harisama1/health-watch/docs/datasheets/README.md

# Datasheet (không kèm file PDF)

Datasheet thuộc bản quyền của các hãng nên repo public chỉ ghi link tải. Tải về đặt đúng tên file bên dưới vào thư mục này thì các script (`tools/facts.py`, `tools/gen_report.py`) và số trang trích dẫn trong báo cáo dùng được ngay.

| Khóa | Tên file | Link tải |
|---|---|---|
| DS | `ESP32-S3_Datasheet.pdf` | https://www.espressif.com/sites/default/files/documentation/esp32-s3_datasheet_en.pdf |
| HDG | `ESP32-S3_Hardware_Design_Guidelines.pdf` | https://docs.espressif.com/projects/esp-hardware-design-guidelines/en/latest/esp32s3/ |
| AXP | `LCSC_C3036461_AXP2101.pdf` | https://datasheet.lcsc.com/datasheet/pdf/4f32bb3c83a61e426b4e09c536b24324.pdf |
| MAX | `LCSC_C5328762_MAX86141.pdf` | https://datasheet.lcsc.com/datasheet/pdf/1b56645c68829ff2d7fd003b7bd91a43.pdf |
| M30 | `LCSC_C2874216_MAX30208.pdf` | https://datasheet.lcsc.com/datasheet/pdf/563d638fdd3523dd5760ec7178c4a6f5.pdf |
| RTC | `PCF85063A.pdf` | https://www.nxp.com/docs/en/data-sheet/PCF85063A.pdf |
| ANT | `Johanson_2450AT18D0100.pdf` | https://datasheet.lcsc.com/datasheet/pdf/43cf7506e0cad9725529346917105458.pdf |
| FPC | `HDGC_0.3K-HX-nPWB.pdf` | https://datasheet.lcsc.com/datasheet/pdf/a443f3b35bf2c7fb425b32754489b934.pdf |
| BMI | `Bosch_BMI270_datasheet.pdf` | https://www.bosch-sensortec.com/media/boschsensortec/downloads/datasheets/bst-bmi270-ds000.pdf |
| TPS | `LCSC_C133991_TPS61240.pdf` | https://datasheet.lcsc.com/datasheet/pdf/91a1f9e8f79a4c3caf35dfe137175767.pdf |
| TXS | `LCSC_C17206_TXS0108E.pdf` | https://datasheet.lcsc.com/datasheet/pdf/3d1219eaadc44a01a8b9ea151a0ff2ba.pdf |
| LP | `LCSC_C92498_LP5907-1.8.pdf` | https://datasheet.lcsc.com/datasheet/pdf/bce283a90e88d150b0b3cedeeb5142ca.pdf |
| W25 | `LCSC_C97521_W25Q128JVSIQ.pdf` | https://datasheet.lcsc.com/datasheet/pdf/d009d960f1daec6149edaa35b7dae856.pdf |
| SFH | `OSRAM_SFH7016.pdf` | https://look.ams-osram.com/m/1a73f8d425cfcc40/original/SFH-7016.pdf |
| VEMD | `LCSC_C511402_VEMD8080.pdf` | https://datasheet.lcsc.com/datasheet/pdf/a9a8ceb088c6fc1e24875b4d80ce77a2.pdf |
| LC6 | `LCSC_C7519_USBLC6-2SC6.pdf` | https://datasheet.lcsc.com/datasheet/pdf/0d3a2ab954b34651a0695e7ccf534db0.pdf |
| TYC | `LCSC_C165948_TYPE-C-31-M-12.pdf` | https://datasheet.lcsc.com/datasheet/pdf/9e56b777c022540fcce7c7f67825f55e.pdf |
| XT | `LCSC_C9010_X322540MPB4SI_40MHz.pdf` | https://datasheet.lcsc.com/datasheet/pdf/a84bd8d530dd46e4b0f6d0ee59d8a89c.pdf |
| TS | `LCSC_C720477_TS-1088_tact_switch.pdf` | https://datasheet.lcsc.com/datasheet/pdf/0475ac02febf455ca9ddcfb380b0df0d.pdf |
| AO | `LCSC_C15127_AO3401A.pdf` | https://datasheet.lcsc.com/datasheet/pdf/fee353dd1e9e0bc90b295f14f381aa4c.pdf |
| WS | `Waveshare_ESP32-S3-Touch-AMOLED-1.75C_schematic.pdf` | https://www.waveshare.com/wiki/ESP32-S3-Touch-AMOLED-1.75C (mục Resources → Schematic) |

Chưa có: NXP PCF85063A (https://www.nxp.com/docs/en/data-sheet/PCF85063A.pdf), Johanson 2450AT18A100, CUI CMT-8504 - xem mục rủi ro trong báo cáo.
