harisama1/health-watch/outputs/bom/health_watch_bom.xlsx

Sheet: Chi phí
Dự toán PCBA JLCPCB (Standard, 2 mặt, mỗi bo một đơn)
Giá đọc ngày 05/11/2026; đổi theo thời điểm
Số bộ (nhập tại đây) | 2
Setup 2 mặt | 51.12
Stencil 2 mặt | 16.42
Nạp feeder mỗi mã | 1.53
Mỗi mối hàn (0,016 + 0,0016) | 0.0176
Đóng gói + xác nhận vị trí | 0.95
Nguồn phí: jlcpcb.com/help/article/pcb-assembly-price
Hạng mục ($) | Bo chính | Bo cảm biến | Tổng
Linh kiện
Setup + stencil
Nạp feeder
Mối hàn
X-ray
Đóng gói + xác nhận vị trí
Tổng PCBA
Mua rời, chưa gồm màn hình
Tổng đã có giá
Chưa gồm: SFH 7016 và màn hình (chưa có giá), MAX86141 tính theo giá niêm yết khi hết hàng, PCB, vận chuyển, thuế, vỏ, phí fixture và handling nếu phát sinh.
Đơn giá dùng bậc 1 nên có thể cao hơn báo giá thật. Bo chưa có layout, nên số mối hàn lấy từ số chân trong design.py.

Sheet: Bo chính
Tham chiếu | SL/bộ | Giá trị | Footprint | Mã LCSC | Thư viện JLC | Tồn JLCPCB | Tồn LCSC | Mua tối thiểu | Hao hụt | Đơn giá bậc 1 ($) | SL mua | Thành tiền ($) | Chân/linh kiện | Mối hàn/bộ | Tính X-ray | Trạng thái
J101 | 1 | TYPE-C-31-M-12 | HW_IC:USB_C_Receptacle_16P_MidMount_TYPE-C-31-M-12 | C165948 | expand | 150499 | 140195 | 2 | 0 | 0.1868 |  |  | 17 |  | 0 | Đặt PCBA được
R101,R102 | 2 | 5.1k | Resistor_SMD:R_0402_1005Metric | C25905 | base | 4703687 | 1764200 | 20 | 15 | 0.0023 |  |  | 2 |  | 0 | Đặt PCBA được
U101 | 1 | USBLC6-2SC6 | Package_TO_SOT_SMD:SOT-23-6 | C7519 | expand | 45596 | 44985 | 5 | 2 | 0.1623 |  |  | 6 |  | 0 | Đặt PCBA được
R103,R104 | 2 | 22 | Resistor_SMD:R_0402_1005Metric | C25092 | base | 3679105 | 0 | 20 | 15 | 0.0019 |  |  | 2 |  | 0 | Đặt PCBA được
U102 | 1 | AXP2101 | Package_DFN_QFN:QFN-40-1EP_5x5mm_P0.4mm_EP3.6x3.6mm_ThermalVias | C3036461 | expand | 3195 | 3195 | 0 | 0 | 1.5618 |  |  | 41 |  | 1 | Đặt PCBA được
C101,C102,C115,C132 | 4 | 10uF 10V | Capacitor_SMD:C_0603_1608Metric | C19702 | base | 10688573 | 1579380 | 20 | 10 | 0.0203 |  |  | 2 |  | 0 | Đặt PCBA được
C103,C104,C111 | 3 | 22uF 6.3V | Capacitor_SMD:C_0603_1608Metric | C59461 | base | 4257105 | 1105580 | 20 | 10 | 0.0171 |  |  | 2 |  | 0 | Đặt PCBA được
C105,C106,C107,C109,C110,C116,C118,C123,C124 | 9 | 1uF | Capacitor_SMD:C_0402_1005Metric | C52923 | base | 9953631 | 1534400 | 20 | 12 | 0.0063 |  |  | 2 |  | 0 | Đặt PCBA được
C108,C113 | 2 | 2.2uF | Capacitor_SMD:C_0402_1005Metric | C12530 | base | 3721393 | 2009500 | 20 | 14 | 0.0054 |  |  | 2 |  | 0 | Đặt PCBA được
L101,L102 | 2 | 1uH 2.5A | Inductor_SMD:L_1008_2520Metric | C97029 | expand | 2402 |  | 5 | 4 | 0.0404 |  |  | 2 |  | 0 | Đặt PCBA được
R105 | 1 | 0R 0805 | Resistor_SMD:R_0805_2012Metric | C17477 | base | 4467978 | 2005100 | 20 | 10 | 0.0044 |  |  | 2 |  | 0 | Đặt PCBA được
RT101 | 1 | NTC 10k B3950 | Resistor_SMD:R_0402_1005Metric | C41366926 | expand | 11106 | 10800 | 20 | 8 | 0.018 |  |  | 2 |  | 0 | Đặt PCBA được
R106 | 1 | 4.7k | Resistor_SMD:R_0402_1005Metric | C25900 | base | 15980267 | 8774700 | 20 | 10 | 0.0017 |  |  | 2 |  | 0 | Đặt PCBA được
R107,R108 | 2 | 2.2k | Resistor_SMD:R_0402_1005Metric | C25879 | base | 3440881 | 1720400 | 20 | 10 | 0.0011 |  |  | 2 |  | 0 | Đặt PCBA được
R109 | 1 | 510 | Resistor_SMD:R_0402_1005Metric | C25123 | base | 2793746 | 1373100 | 20 | 12 | 0.0011 |  |  | 2 |  | 0 | Đặt PCBA được
C112 | 1 | 1nF | Capacitor_SMD:C_0402_1005Metric | C1523 | base | 2225028 | 0 | 20 | 15 | 0.0019 |  |  | 2 |  | 0 | Đặt PCBA được
SW101,SW102,SW103,SW104 | 4 | TS-1088 4x3mm | HW_IC:SW_SPST_TS-1088-xR020 | C720477 | base | 795887 | 576930 | 5 | 4 | 0.0527 |  |  | 2 |  | 0 | Đặt PCBA được
R110,R125 | 2 | 1k | Resistor_SMD:R_0402_1005Metric | C11702 | base | 34052494 | 22437900 | 20 | 10 | 0.0013 |  |  | 2 |  | 0 | Đặt PCBA được
D101 | 1 | Red 0603 | LED_SMD:LED_0603_1608Metric | C2286 | base | 6672378 | 4208500 | 20 | 10 | 0.0077 |  |  | 2 |  | 0 | Đặt PCBA được
J102 | 1 | LiPo 1S ~400mAh | Connector_Molex:Molex_PicoBlade_53261-0271_1x02-1MP_P1.25mm_Horizontal | C177225 | expand | 27625 | 27625 | 2 | 4 | 0.1417 |  |  | 3 |  | 0 | Đặt PCBA được
R111 | 1 | 0.05R 1% 0805 | Resistor_SMD:R_0805_2012Metric | C247602 | expand | 283713 | 283700 | 20 | 10 | 0.0097 |  |  | 2 |  | 0 | Đặt PCBA được
R112,R114 | 2 | 0.1R 1% 0603 | Resistor_SMD:R_0603_1608Metric | C111027 | expand | 73336 | 53400 | 20 | 10 | 0.007 |  |  | 2 |  | 0 | Đặt PCBA được
U103 | 1 | TPS61240DRVT | Package_SON:WSON-6-1EP_2x2mm_P0.65mm_EP1x1.6mm | C133991 | expand | 50 | 50 | 0 | 0 | 1.5389 |  |  | 7 |  | 1 | Đặt PCBA được
L103 | 1 | 1uH 1A | Inductor_SMD:L_0805_2012Metric | C98332 | expand | 42789 |  | 5 | 4 | 0.0591 |  |  | 2 |  | 0 | Đặt PCBA được
C114 | 1 | 4.7uF | Capacitor_SMD:C_0603_1608Metric | C19666 | base | 4144040 | 1307670 | 20 | 10 | 0.015 |  |  | 2 |  | 0 | Đặt PCBA được
R113 | 1 | 1M | Resistor_SMD:R_0402_1005Metric | C26083 | base | 2814158 | 1121900 | 20 | 15 | 0.0015 |  |  | 2 |  | 0 | Đặt PCBA được
U104 | 1 | ESP32-S3R8 | Package_DFN_QFN:QFN-56-1EP_7x7mm_P0.4mm_EP4x4mm_ThermalVias | C2913194 | expand | 10943 | 9607 | 0 | 0 | 3.1464 |  |  | 57 |  | 1 | Đặt PCBA được
C117,C120,C121,C122,C127,C133,C134,C135,C136,C137 | 10 | 100nF | Capacitor_SMD:C_0402_1005Metric | C1525 | base | 32851599 | 3237300 | 20 | 10 | 0.0031 |  |  | 2 |  | 0 | Đặt PCBA được
L104 | 1 | 2.0nH | Inductor_SMD:L_0402_1005Metric | C76769 | expand | 174562 | 174560 | 20 | 10 | 0.015 |  |  | 2 |  | 0 | Đặt PCBA được
C119 | 1 | 10nF | Capacitor_SMD:C_0402_1005Metric | C15195 | base | 5193372 | 1206900 | 20 | 15 | 0.0039 |  |  | 2 |  | 0 | Đặt PCBA được
R115,R116,R119,R124 | 4 | 10k | Resistor_SMD:R_0402_1005Metric | C25744 | base | 14995435 | 0 | 20 | 15 | 0.0028 |  |  | 2 |  | 0 | Đặt PCBA được
Y101 | 1 | 40MHz 10ppm CL15pF | Crystal:Crystal_SMD_3225-4Pin_3.2x2.5mm | C9010 | expand | 67664 | 43950 | 5 | 4 | 0.1093 |  |  | 4 |  | 0 | Đặt PCBA được
L105 | 1 | 24nH | Inductor_SMD:L_0402_1005Metric | C404641 | expand | 22328 | 21300 | 20 | 10 | 0.0128 |  |  | 2 |  | 0 | Đặt PCBA được
C125,C126 | 2 | 22pF C0G | Capacitor_SMD:C_0402_1005Metric | C1555 | base | 1764368 | 538000 | 20 | 10 | 0.0024 |  |  | 2 |  | 0 | Đặt PCBA được
U105 | 1 | W25Q128JVSIQ | Package_SO:SOIC-8_5.3x5.3mm_P1.27mm | C97521 | base | 90072 | 19924 | 0 | 0 | 2.3271 |  |  | 8 |  | 0 | Đặt PCBA được
C128,C129 | 2 | 1.5pF C0G | Capacitor_SMD:C_0201_0603Metric | C88905 | expand | 1086 | 900 | 20 | 10 | 0.0053 |  |  | 2 |  | 0 | Đặt PCBA được
L106 | 1 | 2.4nH | Inductor_SMD:L_0201_0603Metric | C98042 | expand | 85993 | 85950 | 20 | 10 | 0.0114 |  |  | 2 |  | 0 | Đặt PCBA được
R117 | 1 | 0R | Resistor_SMD:R_0201_0603Metric | C106228 | expand | 2753815 | 2568800 | 20 | 12 | 0.0012 |  |  | 2 |  | 0 | Đặt PCBA được
AE101 | 1 | 2450AT18D0100E | HW_Watch:Johanson_2450AT18D_3.2x1.6mm | C2917718 | expand | 1642 | 1642 | 0 | 0 | 0.7163 |  |  | 4 |  | 0 | Đặt PCBA được
R118 | 1 | 499 | Resistor_SMD:R_0402_1005Metric | C4125 | expand | 698887 | 549800 | 20 | 10 | 0.001 |  |  | 2 |  | 0 | Đặt PCBA được
J103 | 1 | UART0 1x03 2.54 | Connector_PinHeader_2.54mm:PinHeader_1x03_P2.54mm_Vertical | C2937625 | expand | 709610 | 582800 | 2 | 2 | 0.0198 |  |  | 3 | 0 | 0 | Mua rời, hàn tay
J104 | 1 | 0.3K-HX-31PWB | HW_Watch:FPC_HDGC_0.3K-HX-31PWB | C2919530 | expand | 1167 | 1167 | 0 | 0 | 0.3255 |  |  | 32 |  | 0 | Đặt PCBA được
U106 | 1 | BMI270 | Package_LGA:Bosch_LGA-14_3x2.5mm_P0.5mm | C2836813 | expand | 17089 | 16744 | 0 | 0 | 2.5904 |  |  | 14 |  | 1 | Đặt PCBA được
U107 | 1 | PCF85063ATT/AJ | Package_SO:TSSOP-8_3x3mm_P0.65mm | C165608 | expand | 5264 | 5264 | 2 | 0 | 0.8128 |  |  | 8 |  | 0 | Đặt PCBA được
Y102 | 1 | 32.768kHz CL7pF | Crystal:Crystal_SMD_2012-2Pin_2.0x1.2mm | C97602 | expand | 8204 | 8200 | 5 | 0 | 0.253 |  |  | 2 |  | 0 | Đặt PCBA được
Q101,Q102 | 2 | AO3400A | Package_TO_SOT_SMD:SOT-23 | C20917 | base | 923681 | 407020 | 5 | 4 | 0.0888 |  |  | 3 |  | 0 | Đặt PCBA được
R120,R122 | 2 | 100 | Resistor_SMD:R_0402_1005Metric | C25076 | base | 11891606 | 7413500 | 20 | 15 | 0.0012 |  |  | 2 |  | 0 | Đặt PCBA được
R121,R123 | 2 | 100k | Resistor_SMD:R_0402_1005Metric | C25741 | base | 7227887 | 676100 | 20 | 12 | 0.0013 |  |  | 2 |  | 0 | Đặt PCBA được
M101 | 1 | Coin motor 1027 3V | HW_Watch:Motor_Pads_2x1.5mm | C2759984 | expand | 6595 |  | 2 | 0 | 0.5691 |  |  | 2 | 0 | 0 | Mua rời, hàn tay
D102,D103 | 2 | BAT54WS | Diode_SMD:D_SOD-323 | C22629 | expand | 13443 | 13440 | 20 | 6 | 0.029 |  |  | 2 |  | 0 | Đặt PCBA được
BZ101 | 1 | CMT-8504-100-SMT-TR | Buzzer_Beeper:MagneticBuzzer_CUI_CMT-8504-100-SMT | C22359707 | expand | 538 | 418 | 0 | 0 | 2.5593 |  |  | 2 |  | 0 | Đặt PCBA được
D104 | 1 | Green 0603 | LED_SMD:LED_0603_1608Metric | C12624 | expand | 358597 | 355400 | 20 | 16 | 0.0119 |  |  | 2 |  | 0 | Đặt PCBA được
J105 | 1 | FH12-16S-0.5SH | Connector_FFC-FPC:Hirose_FH12-16S-0.5SH_1x16-1MP_P0.50mm_Horizontal | C596731 | expand | 2326 | 2004 | 0 | 0 | 0.9469 |  |  | 17 |  | 0 | Đặt PCBA được
Tổng

Sheet: Bo cảm biến
Tham chiếu | SL/bộ | Giá trị | Footprint | Mã LCSC | Thư viện JLC | Tồn JLCPCB | Tồn LCSC | Mua tối thiểu | Hao hụt | Đơn giá bậc 1 ($) | SL mua | Thành tiền ($) | Chân/linh kiện | Mối hàn/bộ | Tính X-ray | Trạng thái
J201 | 1 | FH12-16S-0.5SH | Connector_FFC-FPC:Hirose_FH12-16S-0.5SH_1x16-1MP_P0.50mm_Horizontal | C596731 | expand | 2326 | 2004 | 0 | 0 | 0.9469 |  |  | 17 |  | 0 | Đặt PCBA được
C201,C202,C208 | 3 | 10uF 10V | Capacitor_SMD:C_0603_1608Metric | C19702 | base | 10688573 | 1579360 | 20 | 10 | 0.0203 |  |  | 2 |  | 0 | Đặt PCBA được
C203,C207,C209,C211,C212,C213 | 6 | 100nF | Capacitor_SMD:C_0402_1005Metric | C1525 | base | 32851595 | 3237300 | 20 | 10 | 0.0031 |  |  | 2 |  | 0 | Đặt PCBA được
U201 | 1 | LP5907MFX-1.8 | Package_TO_SOT_SMD:SOT-23-5 | C92498 | expand | 25494 | 25490 | 5 | 2 | 0.193 |  |  | 5 |  | 0 | Đặt PCBA được
C204,C206 | 2 | 1uF | Capacitor_SMD:C_0402_1005Metric | C52923 | base | 9953629 | 1534400 | 20 | 12 | 0.0063 |  |  | 2 |  | 0 | Đặt PCBA được
R201 | 1 | 0.1R 1% 0603 | Resistor_SMD:R_0603_1608Metric | C111027 | expand | 73336 | 53400 | 20 | 10 | 0.007 |  |  | 2 |  | 0 | Đặt PCBA được
U202 | 1 | MAX86141ENP+T | HW_Watch:MAX86141_WLP-20_2.05x1.85mm_P0.4mm | C5328762 | expand | 0 | 0 | 0 | 0 | 5.4997 |  |  | 20 |  | 1 | HẾT HÀNG trên JLCPCB và LCSC
D201 | 1 | SFH 7016 | HW_Watch:SFH7016_1.85x1.65mm | Q65112A7849 (mã ams-OSRAM; chưa có mã LCSC xác nhận) |  | 0 |  | 0 | 0 |  |  | 0.00 | 6 |  | 1 | KHÔNG CÓ trên JLCPCB/LCSC
D202,D203 | 2 | VEMD8080 | HW_Watch:VEMD8080_4.8x2.5mm | C511402 | expand | 2174 | 2174 | 0 | 0 | 1.014 |  |  | 8 |  | 2 | Đặt PCBA được
R205 | 1 | 0R | Resistor_SMD:R_0402_1005Metric | C17168 | base | 14617478 | 6677200 | 20 | 10 | 0.0011 |  |  | 2 |  | 0 | Đặt PCBA được
U203 | 1 | TXS0108EPWR | Package_SO:TSSOP-20_4.4x6.5mm_P0.65mm | C17206 | expand | 61906 | 61690 | 0 | 0 | 0.4056 |  |  | 20 |  | 0 | Đặt PCBA được
U204 | 1 | MAX30208CLB+ | HW_Watch:MAX30208_LGA-10_2x2mm_PRELIM | C2874216 | expand | 240 | 240 | 0 | 0 | 3.0565 |  |  | 10 |  | 1 | Đặt PCBA được
R203,R204 | 2 | 10k | Resistor_SMD:R_0402_1005Metric | C25744 | base | 14995435 | 0 | 20 | 15 | 0.0028 |  |  | 2 |  | 0 | Đặt PCBA được
Tổng

Sheet: Mua rời
Hạng mục | SL/bộ | Mã LCSC | Tồn JLCPCB | Tồn LCSC | Đơn giá ($) | SL mua | Thành tiền ($) | Ghi chú
Pin LiPo 390 mAh, 28×27×5 mm (FLY.502728.390) | 1 | C5154896 | 11 |  | 1.5225 |  |  | Cần xác nhận đầu nối, NTC và điều kiện giao pin về Việt Nam
Cáp FFC 16P 0,5 mm, 50 mm, ngược mặt | 1 | C5242797 | 1467 | 1460 | 0.0723 |  |  | Độ dài và loại cáp chốt theo vỏ
UART0 1x03 2.54 | 1 | C2937625 | 709610 | 582800 | 0.0198 |  |  | Không nằm trong đơn SMT
Coin motor 1027 3V | 1 | C2759984 | 6595 |  | 0.5691 |  |  | Không nằm trong đơn SMT
Màn AMOLED 1,75" CO5300 + cảm ứng | 1 |  |  |  |  |  |  | KHÔNG CÓ trên JLCPCB/LCSC. Chưa tính giá; cần chốt nhà cung cấp, chân FPC và IC cảm ứng
Tổng (chưa gồm màn hình)
