harisama1/health-watch/outputs/health_watch_main_schematic.pdf

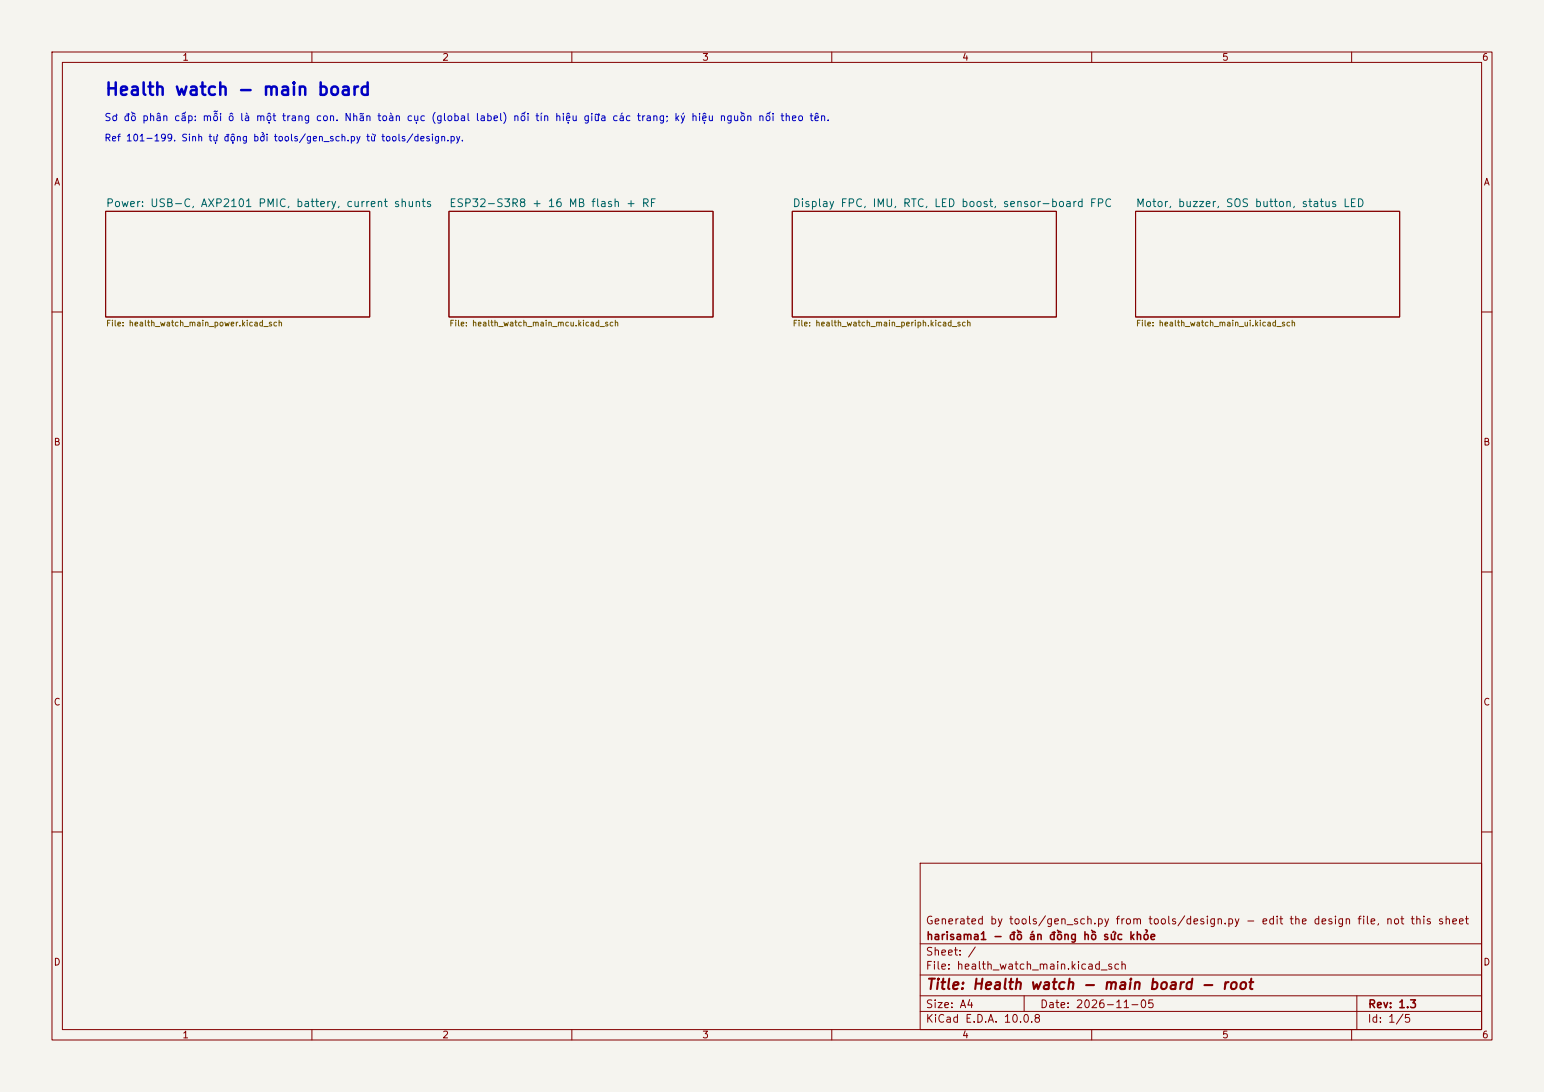
[picture p18: page 1]

File: health_watch_main_ui.kicad_sch Health watch - main board

Sơ đồ phân cấp: mỗi ô là một trang con. Nhãn toàn cục (global label) nối tín hiệu giữa các trang; ký hiệu nguồn nối theo tên. Ref 101-199. Sinh tự động bởi tools/gen_sch.py từ tools/design.py.

Power: USB-C, AXP2101 PMIC, battery, current shunts

Motor, buzzer, SOS button, status LED

Generated by tools/gen_sch.py from tools/design.py - edit the design file, not this sheet
harisama1 - đồ án đồng hồ sức khỏe
Sheet: /
File: health_watch_main.kicad_sch
Title: Health watch - main board - root

Size: A4 | Rev: 1.3
KiCad E.D.A. 10.0.8 | Id: 1/5

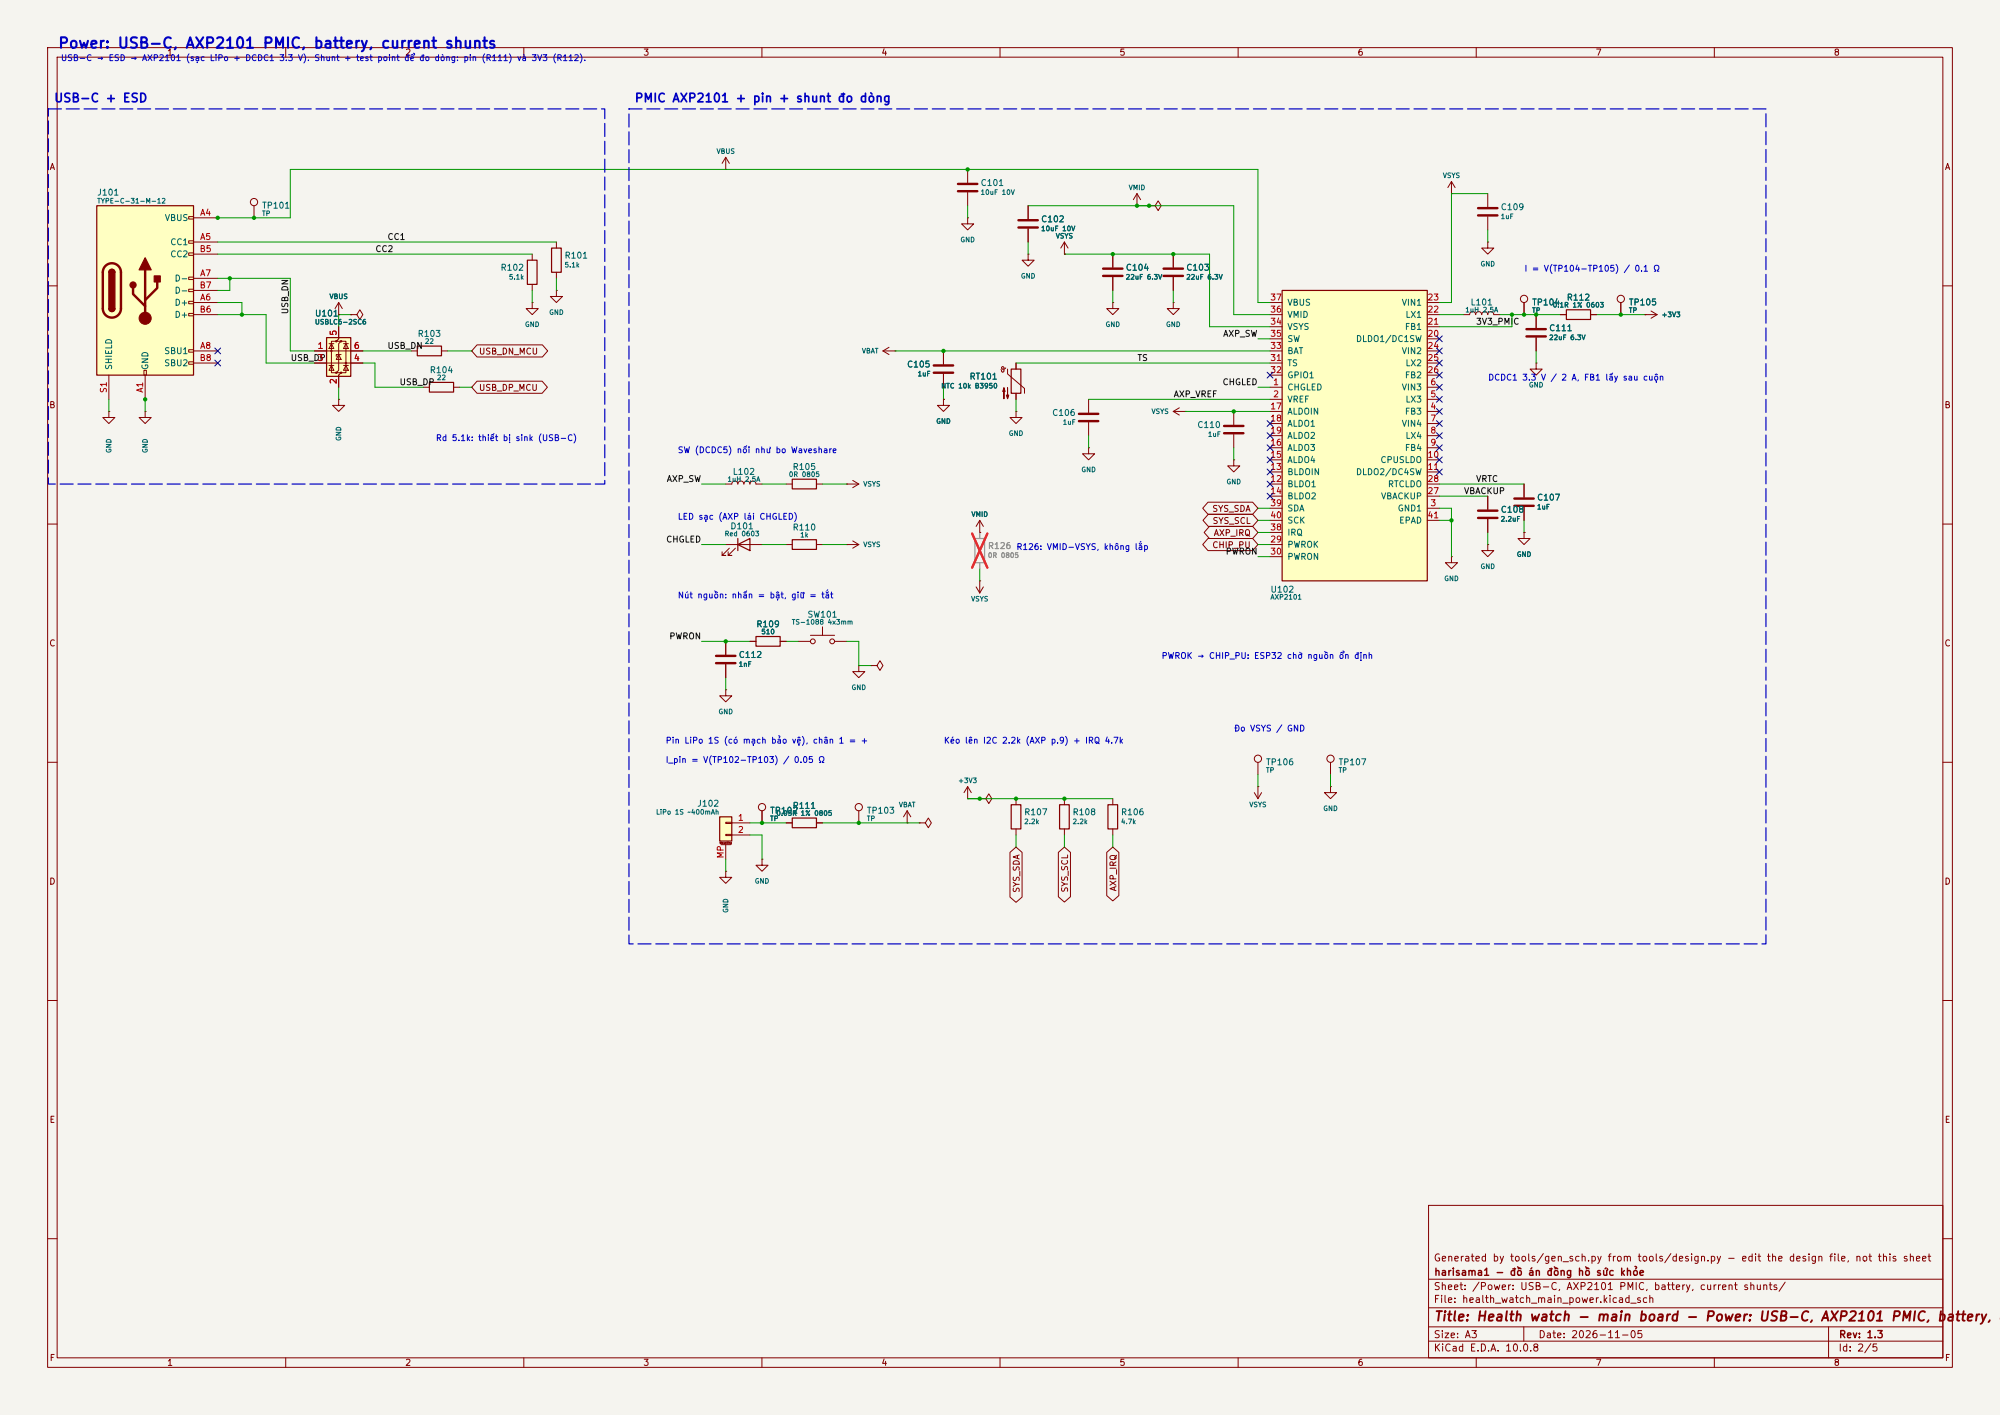
[picture p19: page 2]

Power: USB-C, AXP2101 PMIC, battery, current shunts

USB-C → ESD → AXP2101 (sạc LiPo + DCDC1 3.3 V). Shunt + test point để đo dòng: pin (R111) và 3V3 (R112).

PMIC AXP2101 + pin + shunt đo dòng

Pin LiPo 1S (có mạch bảo vệ), chân 1 = +

Generated by tools/gen_sch.py from tools/design.py - edit the design file, not this sheet
harisama1 - đồ án đồng hồ sức khỏe
Sheet: /Power: USB-C, AXP2101 PMIC, battery, current shunts/
File: health_watch_main_power.kicad_sch
Title: Health watch - main board - Power: USB-C, AXP2101 PMIC, battery, current shunts

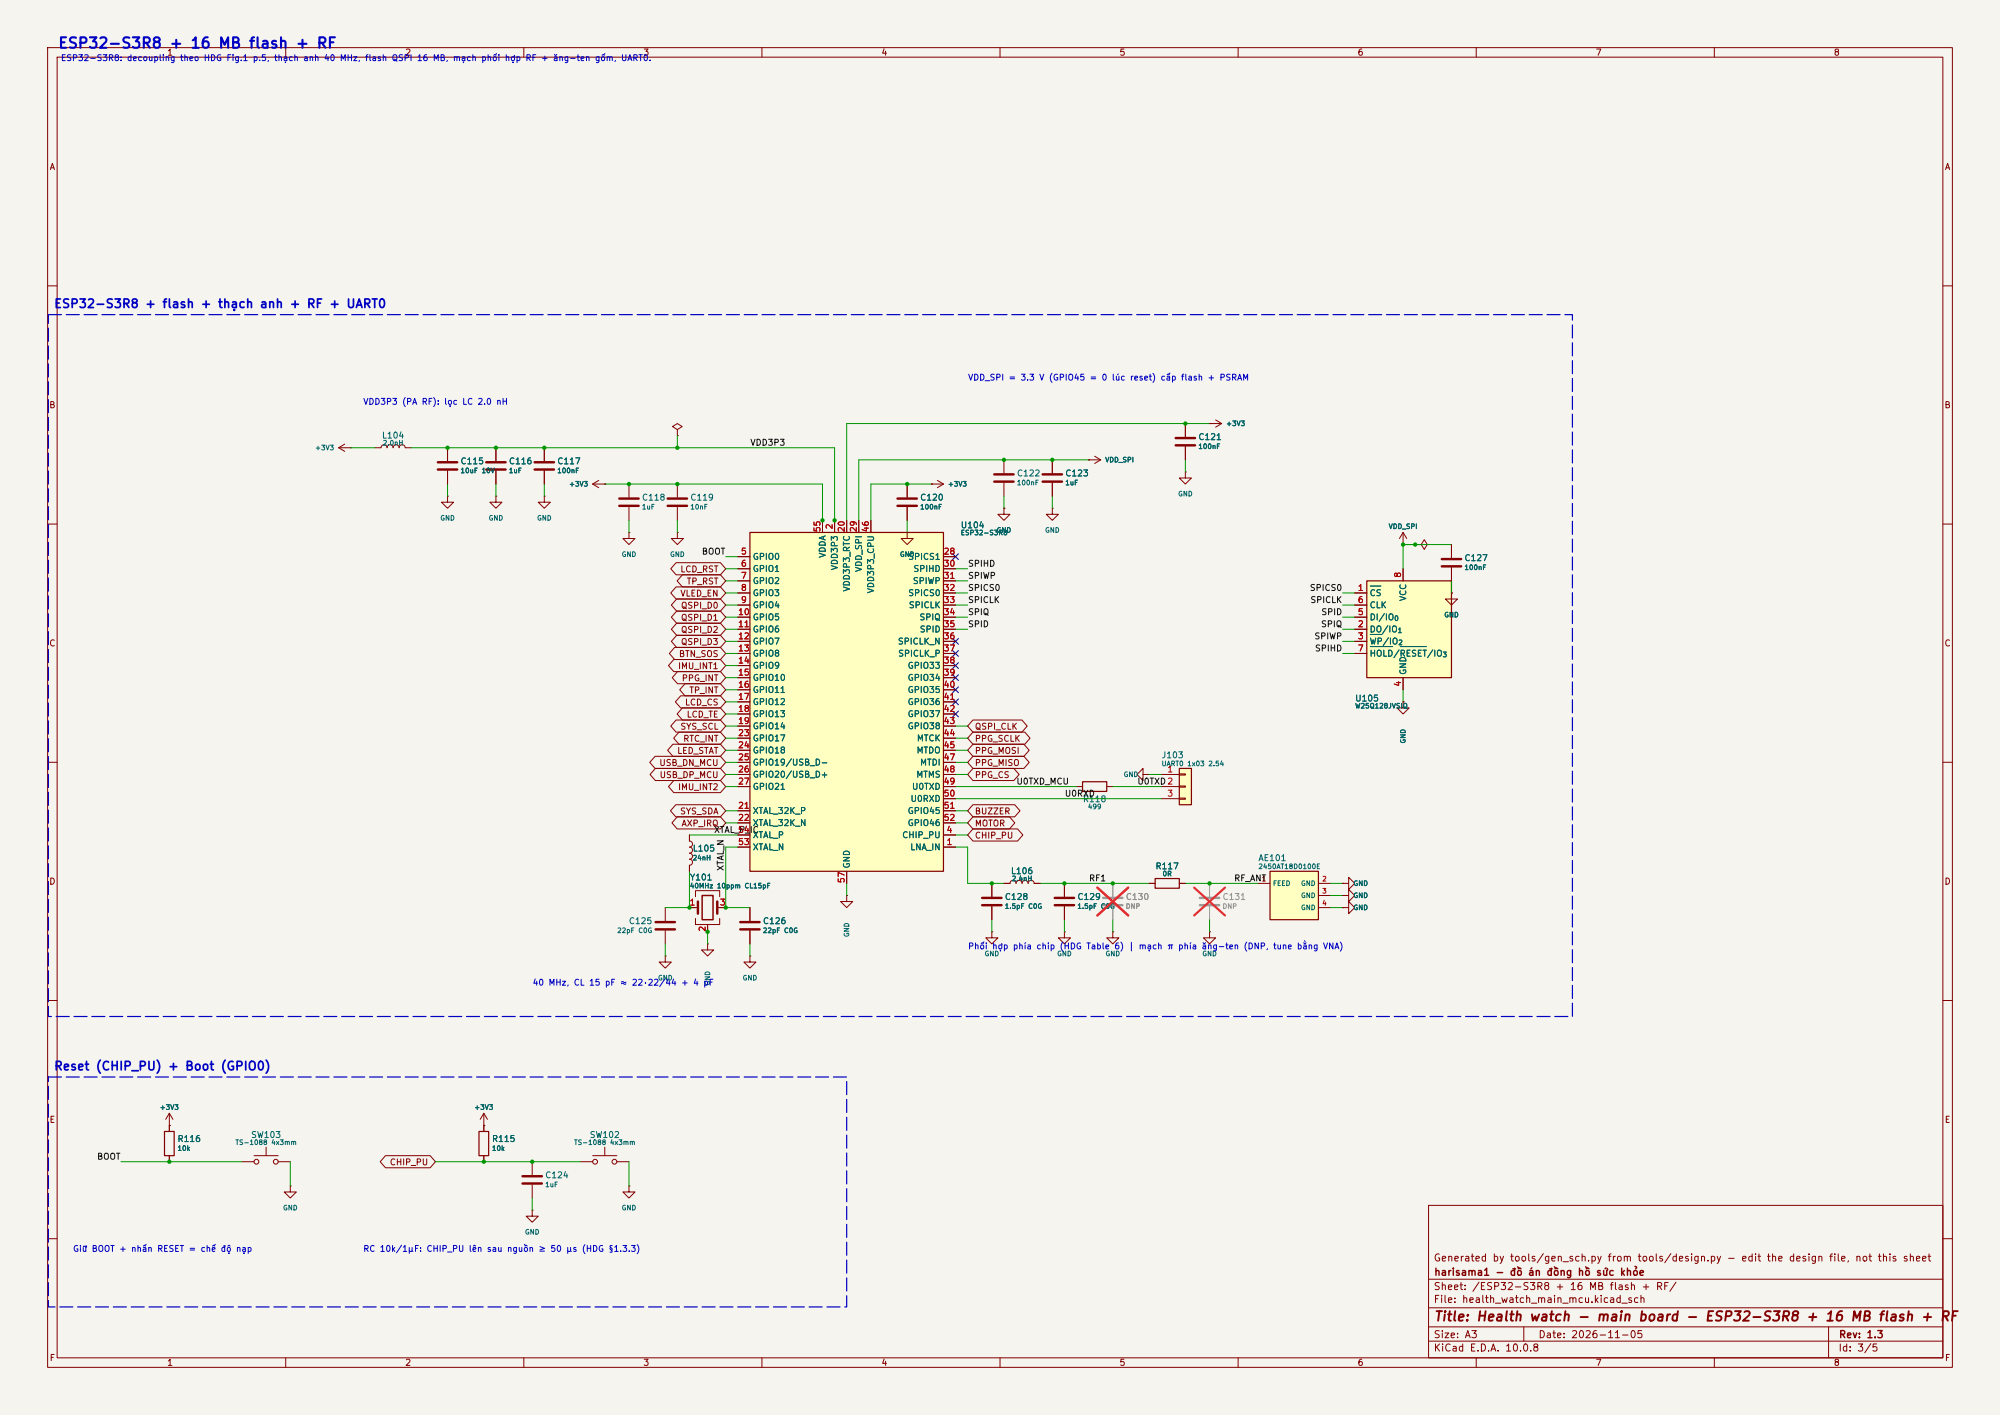
[picture p20: page 3]

VDD3P3 (PA RF): lọc LC 2.0 nH ESP32-S3R8 + 16 MB flash + RF

ESP32-S3R8: decoupling theo HDG Fig.1 p.5, thạch anh 40 MHz, flash QSPI 16 MB, mạch phối hợp RF + ăng-ten gốm, UART0. ESP32-S3R8 + flash + thạch anh + RF + UART0

VDD_SPI = 3.3 V (GPIO45 = 0 lúc reset) cấp flash + PSRAM
ESP32-S3R8 SPICLK_N 36 MTDO 45 GPIO45 51

4 DI/IO0 5 CLK 6 HOLD/RESET/IO3 7 VCC

Phối hợp phía chip (HDG Table 6) | mạch π phía ăng-ten (DNP, tune bằng VNA)

40 MHz, CL 15 pF ≈ 22·22/44 + 4 pF

Generated by tools/gen_sch.py from tools/design.py - edit the design file, not this sheet
harisama1 - đồ án đồng hồ sức khỏe
Sheet: /ESP32-S3R8 + 16 MB flash + RF/
File: health_watch_main_mcu.kicad_sch
Title: Health watch - main board - ESP32-S3R8 + 16 MB flash + RF

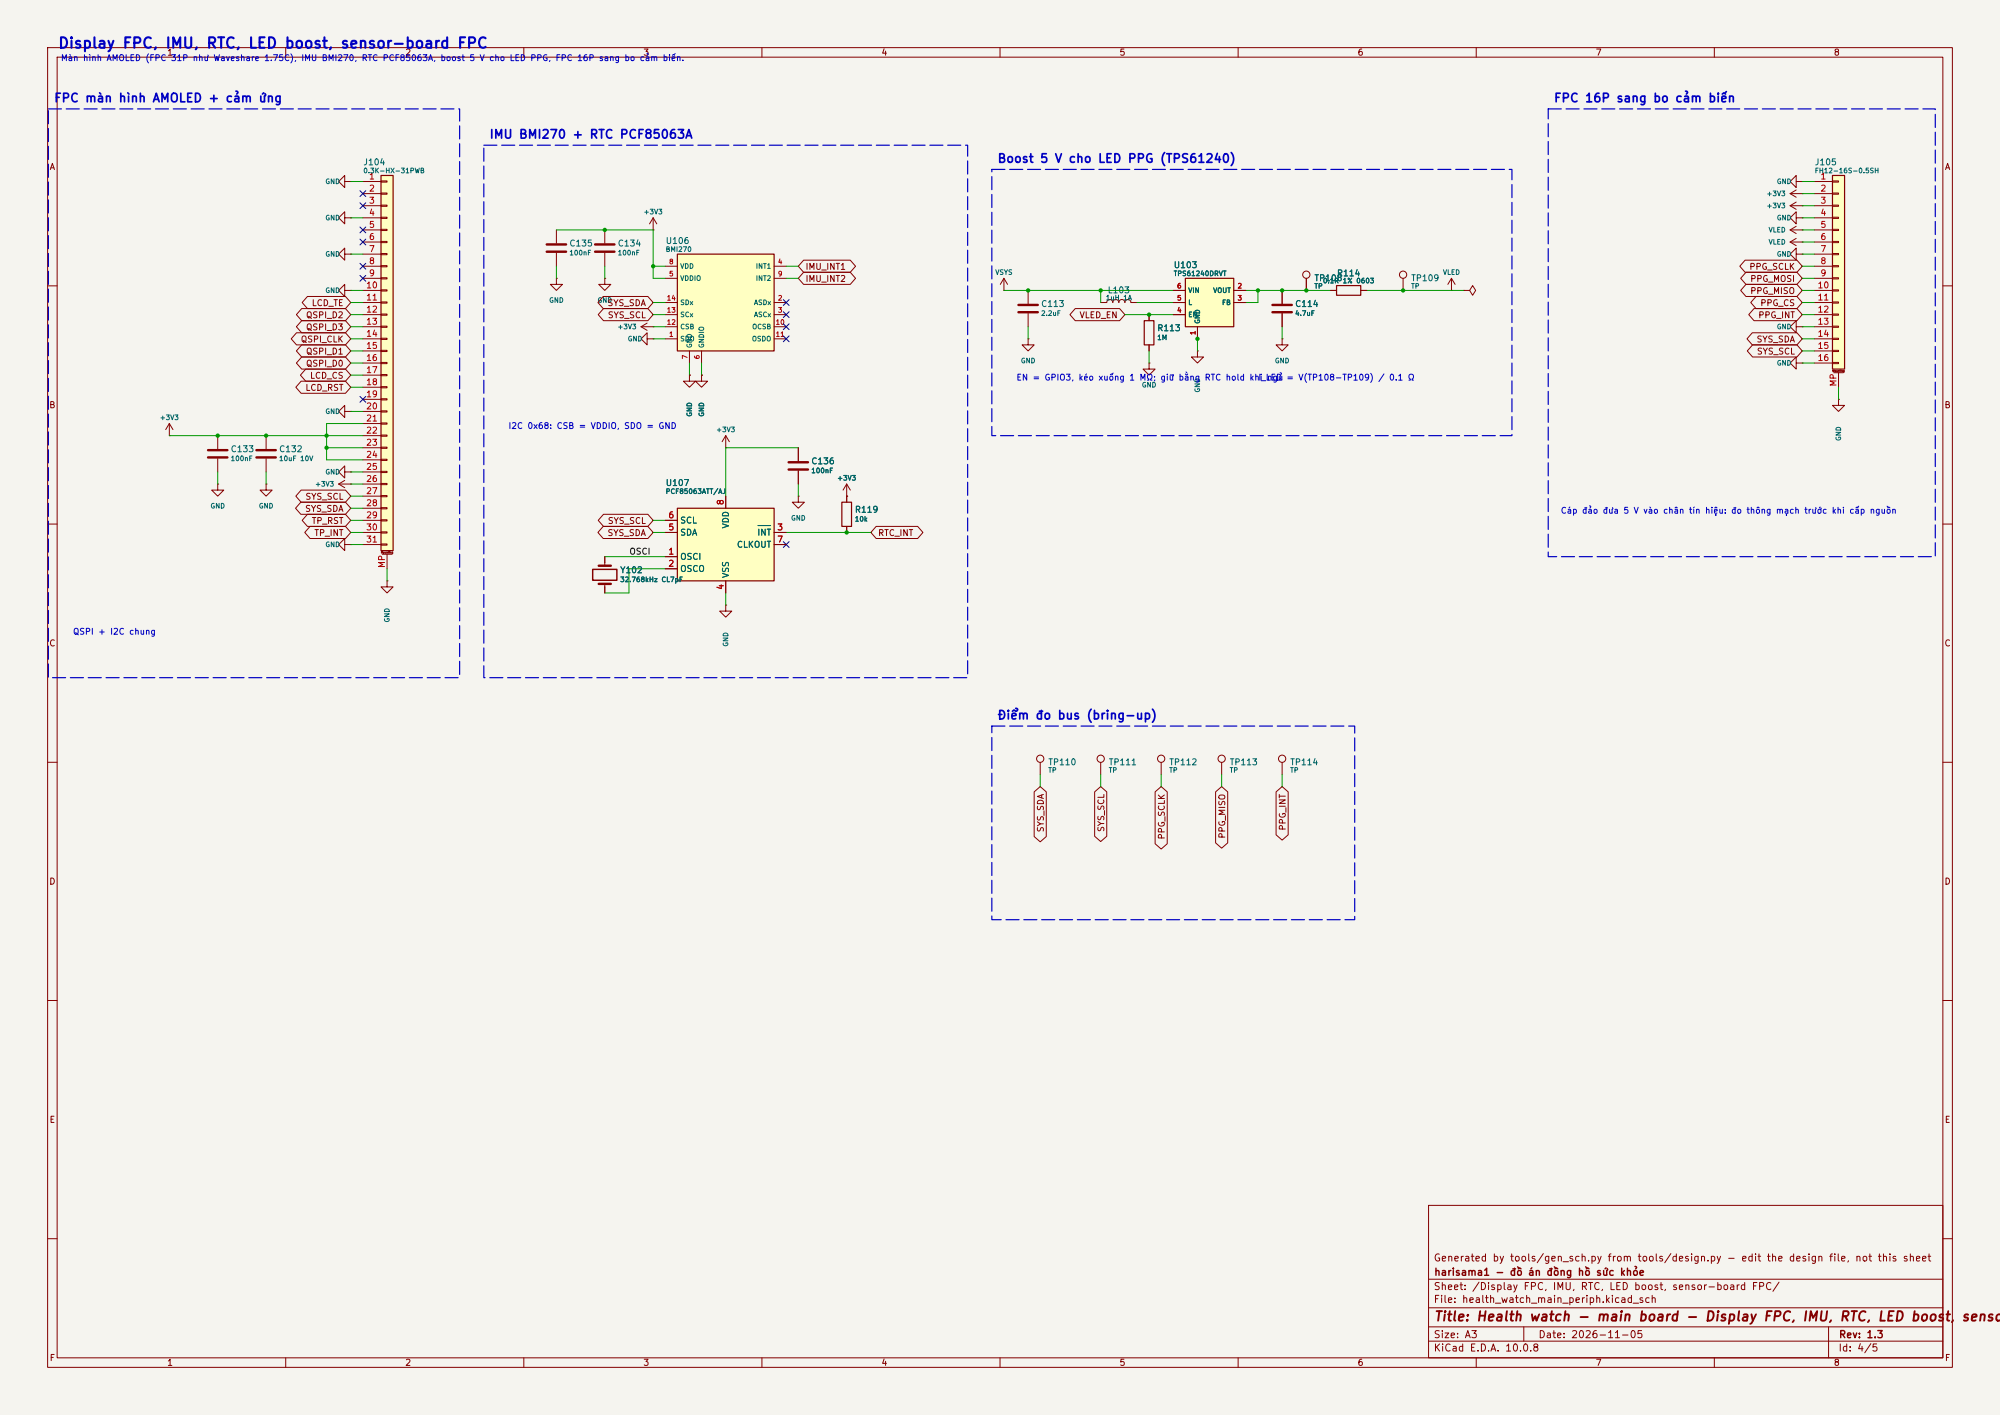
[picture p21: page 4]

Display FPC, IMU, RTC, LED boost, sensor-board FPC

I2C 0x68: CSB = VDDIO, SDO = GND Màn hình AMOLED (FPC 31P như Waveshare 1.75C), IMU BMI270, RTC PCF85063A, boost 5 V cho LED PPG, FPC 16P sang bo cảm biến.

FPC màn hình AMOLED + cảm ứng

FPC 16P sang bo cảm biến

Boost 5 V cho LED PPG (TPS61240)

EN = GPIO3, kéo xuống 1 MΩ; giữ bằng RTC hold khi ngủ GND GND Y102

Generated by tools/gen_sch.py from tools/design.py - edit the design file, not this sheet GND

Cáp đảo đưa 5 V vào chân tín hiệu: đo thông mạch trước khi cấp nguồn QSPI + I2C chung

Điểm đo bus (bring-up)

harisama1 - đồ án đồng hồ sức khỏe
Sheet: /Display FPC, IMU, RTC, LED boost, sensor-board FPC/
File: health_watch_main_periph.kicad_sch
Title: Health watch - main board - Display FPC, IMU, RTC, LED boost, sensor-board FPC

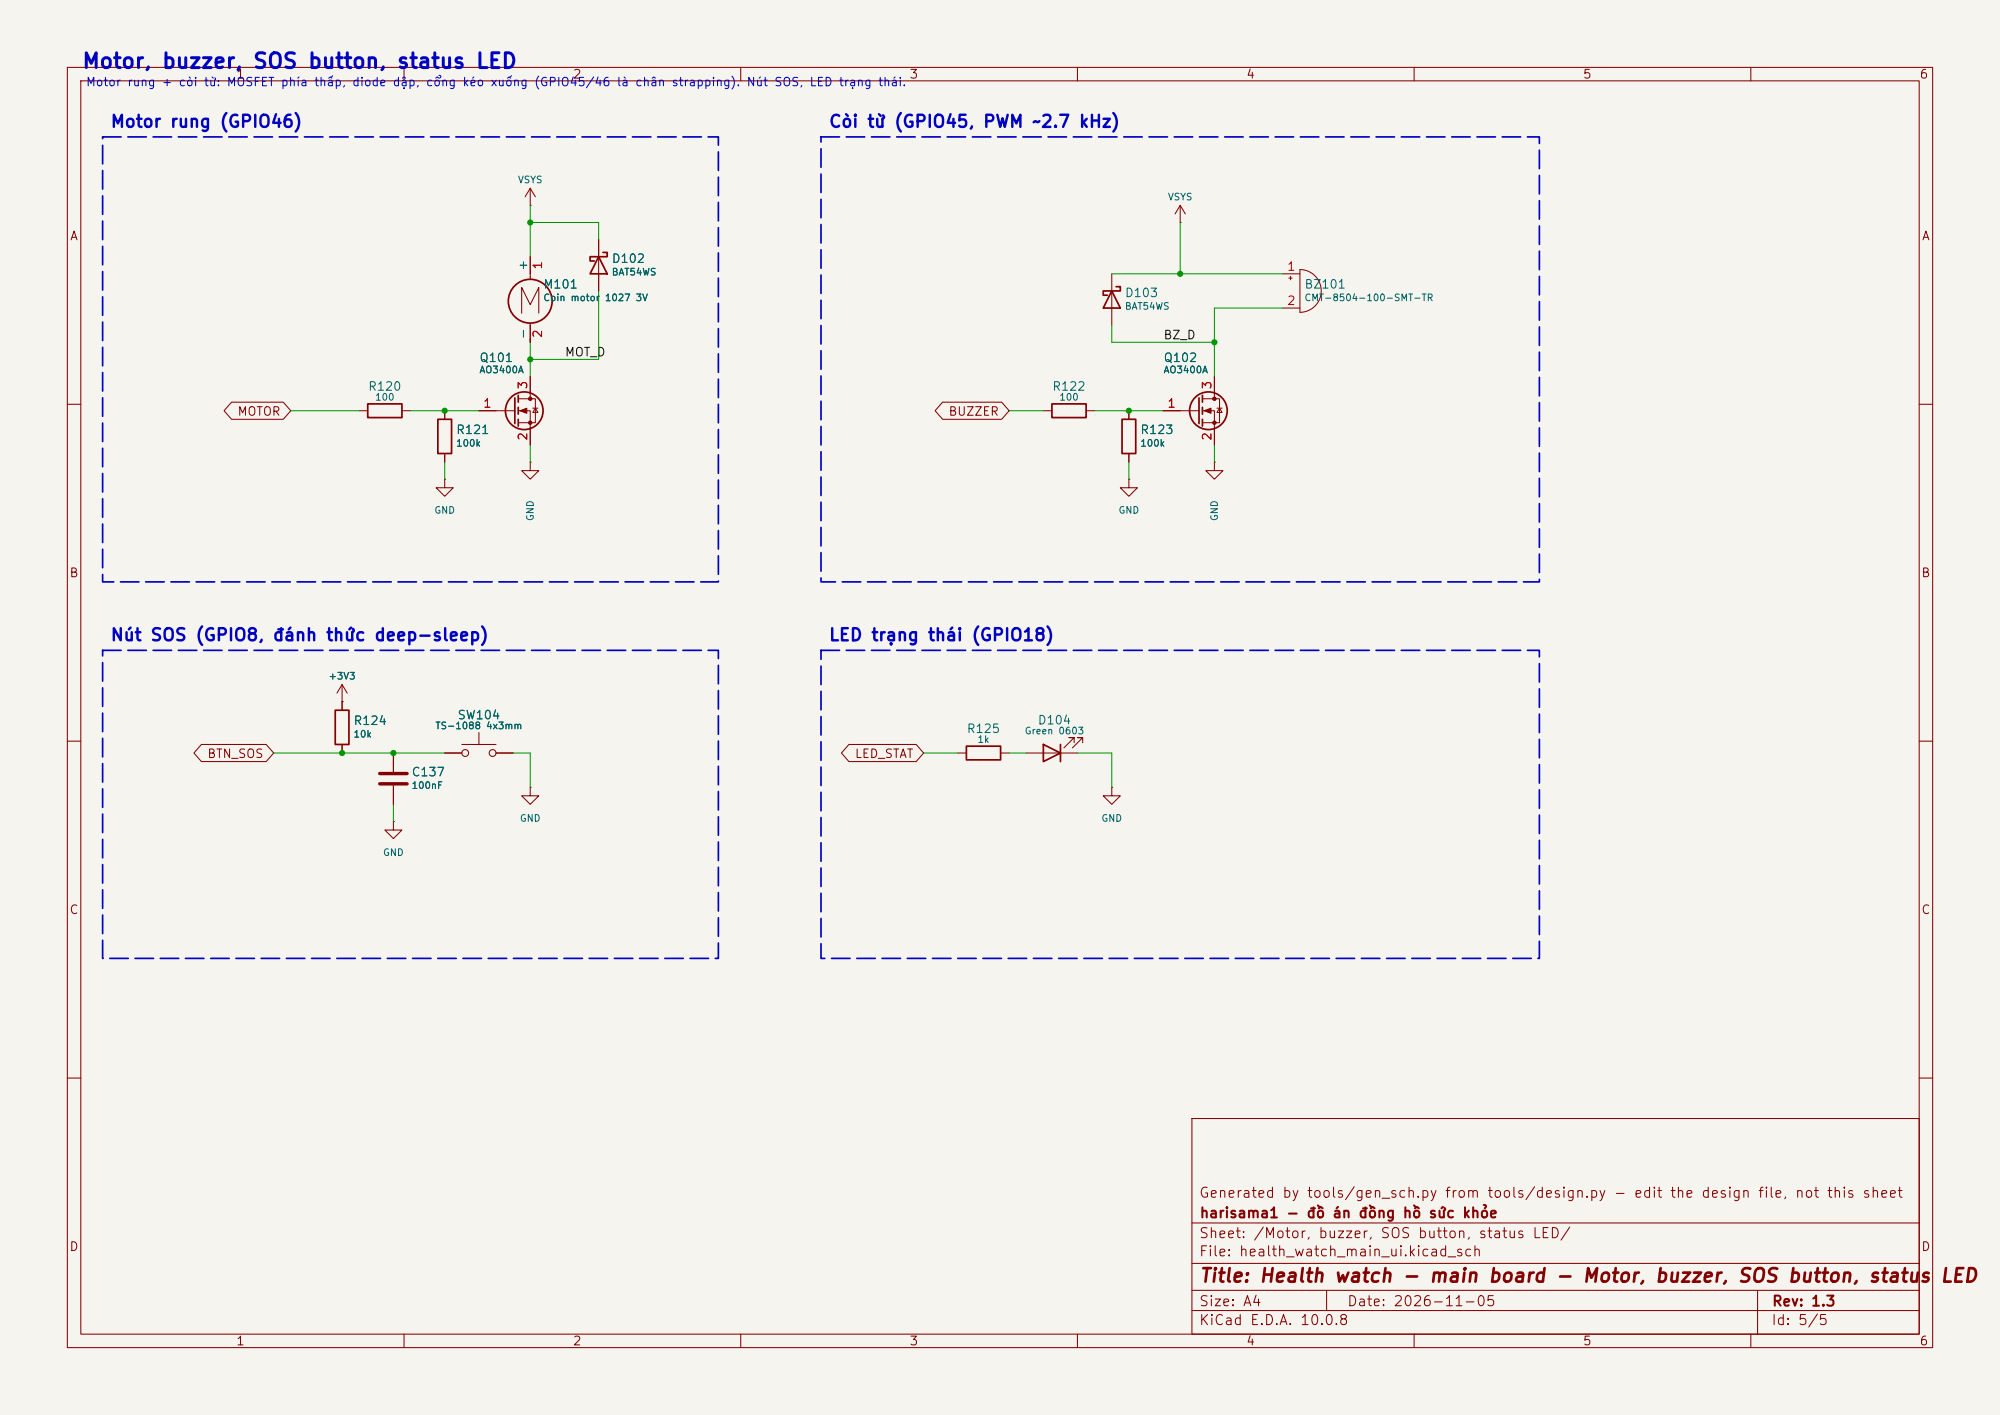
[picture p22: page 5]

Motor, buzzer, SOS button, status LED

Nút SOS (GPIO8, đánh thức deep-sleep)

Generated by tools/gen_sch.py from tools/design.py - edit the design file, not this sheet
harisama1 - đồ án đồng hồ sức khỏe
Sheet: /Motor, buzzer, SOS button, status LED/
File: health_watch_main_ui.kicad_sch
Title: Health watch - main board - Motor, buzzer, SOS button, status LED
