harisama1/health-watch/outputs/health_watch_sensor_schematic.pdf

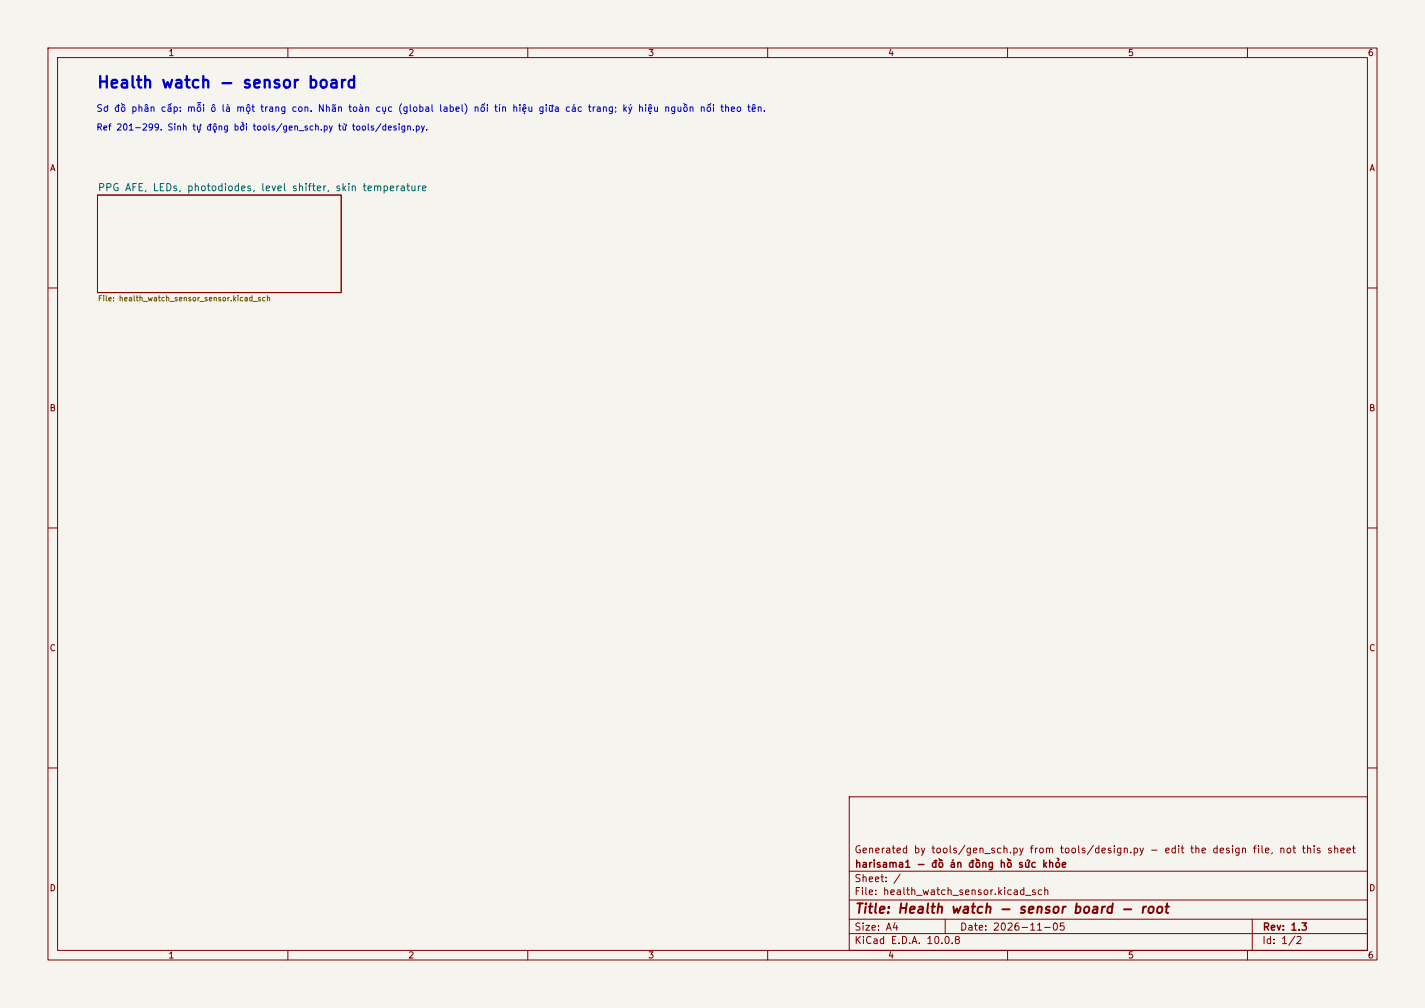
[picture p23: page 1]

File: health_watch_sensor_sensor.kicad_sch Health watch - sensor board

Sơ đồ phân cấp: mỗi ô là một trang con. Nhãn toàn cục (global label) nối tín hiệu giữa các trang; ký hiệu nguồn nối theo tên. Ref 201-299. Sinh tự động bởi tools/gen_sch.py từ tools/design.py.

PPG AFE, LEDs, photodiodes, level shifter, skin temperature

Generated by tools/gen_sch.py from tools/design.py - edit the design file, not this sheet
harisama1 - đồ án đồng hồ sức khỏe
Sheet: /
File: health_watch_sensor.kicad_sch
Title: Health watch - sensor board - root

Size: A4 | Rev: 1.3
KiCad E.D.A. 10.0.8 | Id: 1/2

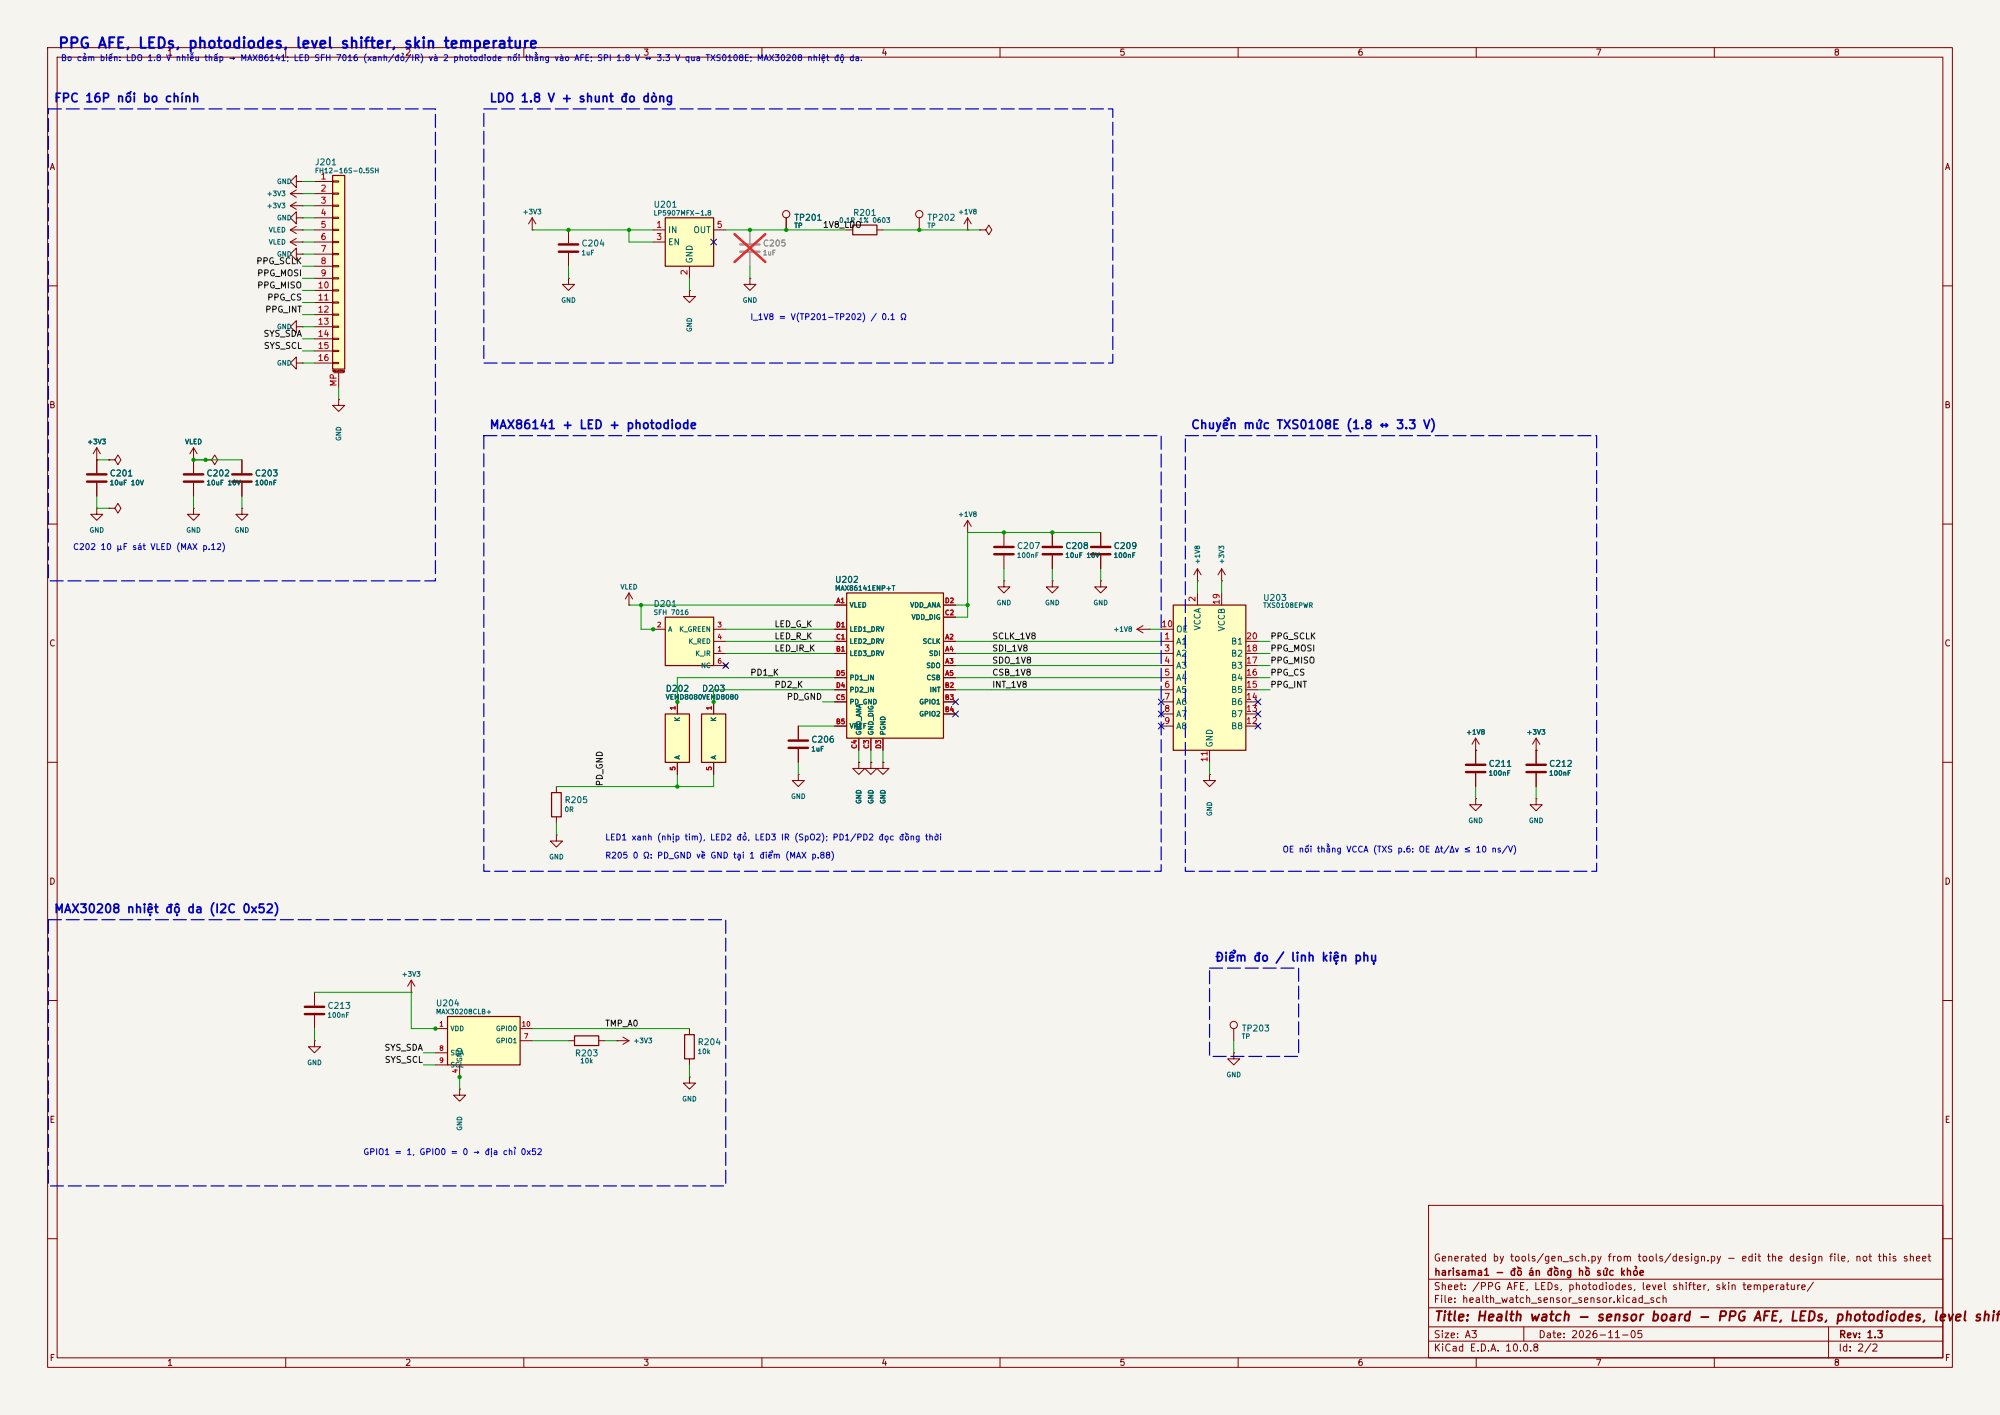
[picture p24: page 2]

PPG AFE, LEDs, photodiodes, level shifter, skin temperature

GND
C202 10 µF sát VLED (MAX p.12)

LED1_DRV D1

LED_IR_K | LED3_DRV B1 | SDI_1V8 | | A2 3

INT_1V8 CSB_1V8 | A4 5

VREF B5 | A6 7

OE nối thẳng VCCA (TXS p.6: OE Δt/Δv ≤ 10 ns/V)

Generated by tools/gen_sch.py from tools/design.py - edit the design file, not this sheet +3V3

harisama1 - đồ án đồng hồ sức khỏe
Sheet: /PPG AFE, LEDs, photodiodes, level shifter, skin temperature/
File: health_watch_sensor_sensor.kicad_sch
Title: Health watch - sensor board - PPG AFE, LEDs, photodiodes, level shifter, skin temperature

Size: A3 | Rev: 1.3 | F Date: 2026-11-05
KiCad E.D.A. 10.0.8 | Id: 2/2
