harisama1/health-watch/hardware/main/health_watch_main_mcu.kicad_sch

## KiCad design hardware/main/health_watch_main_mcu.kicad_sch (2026-11-05)

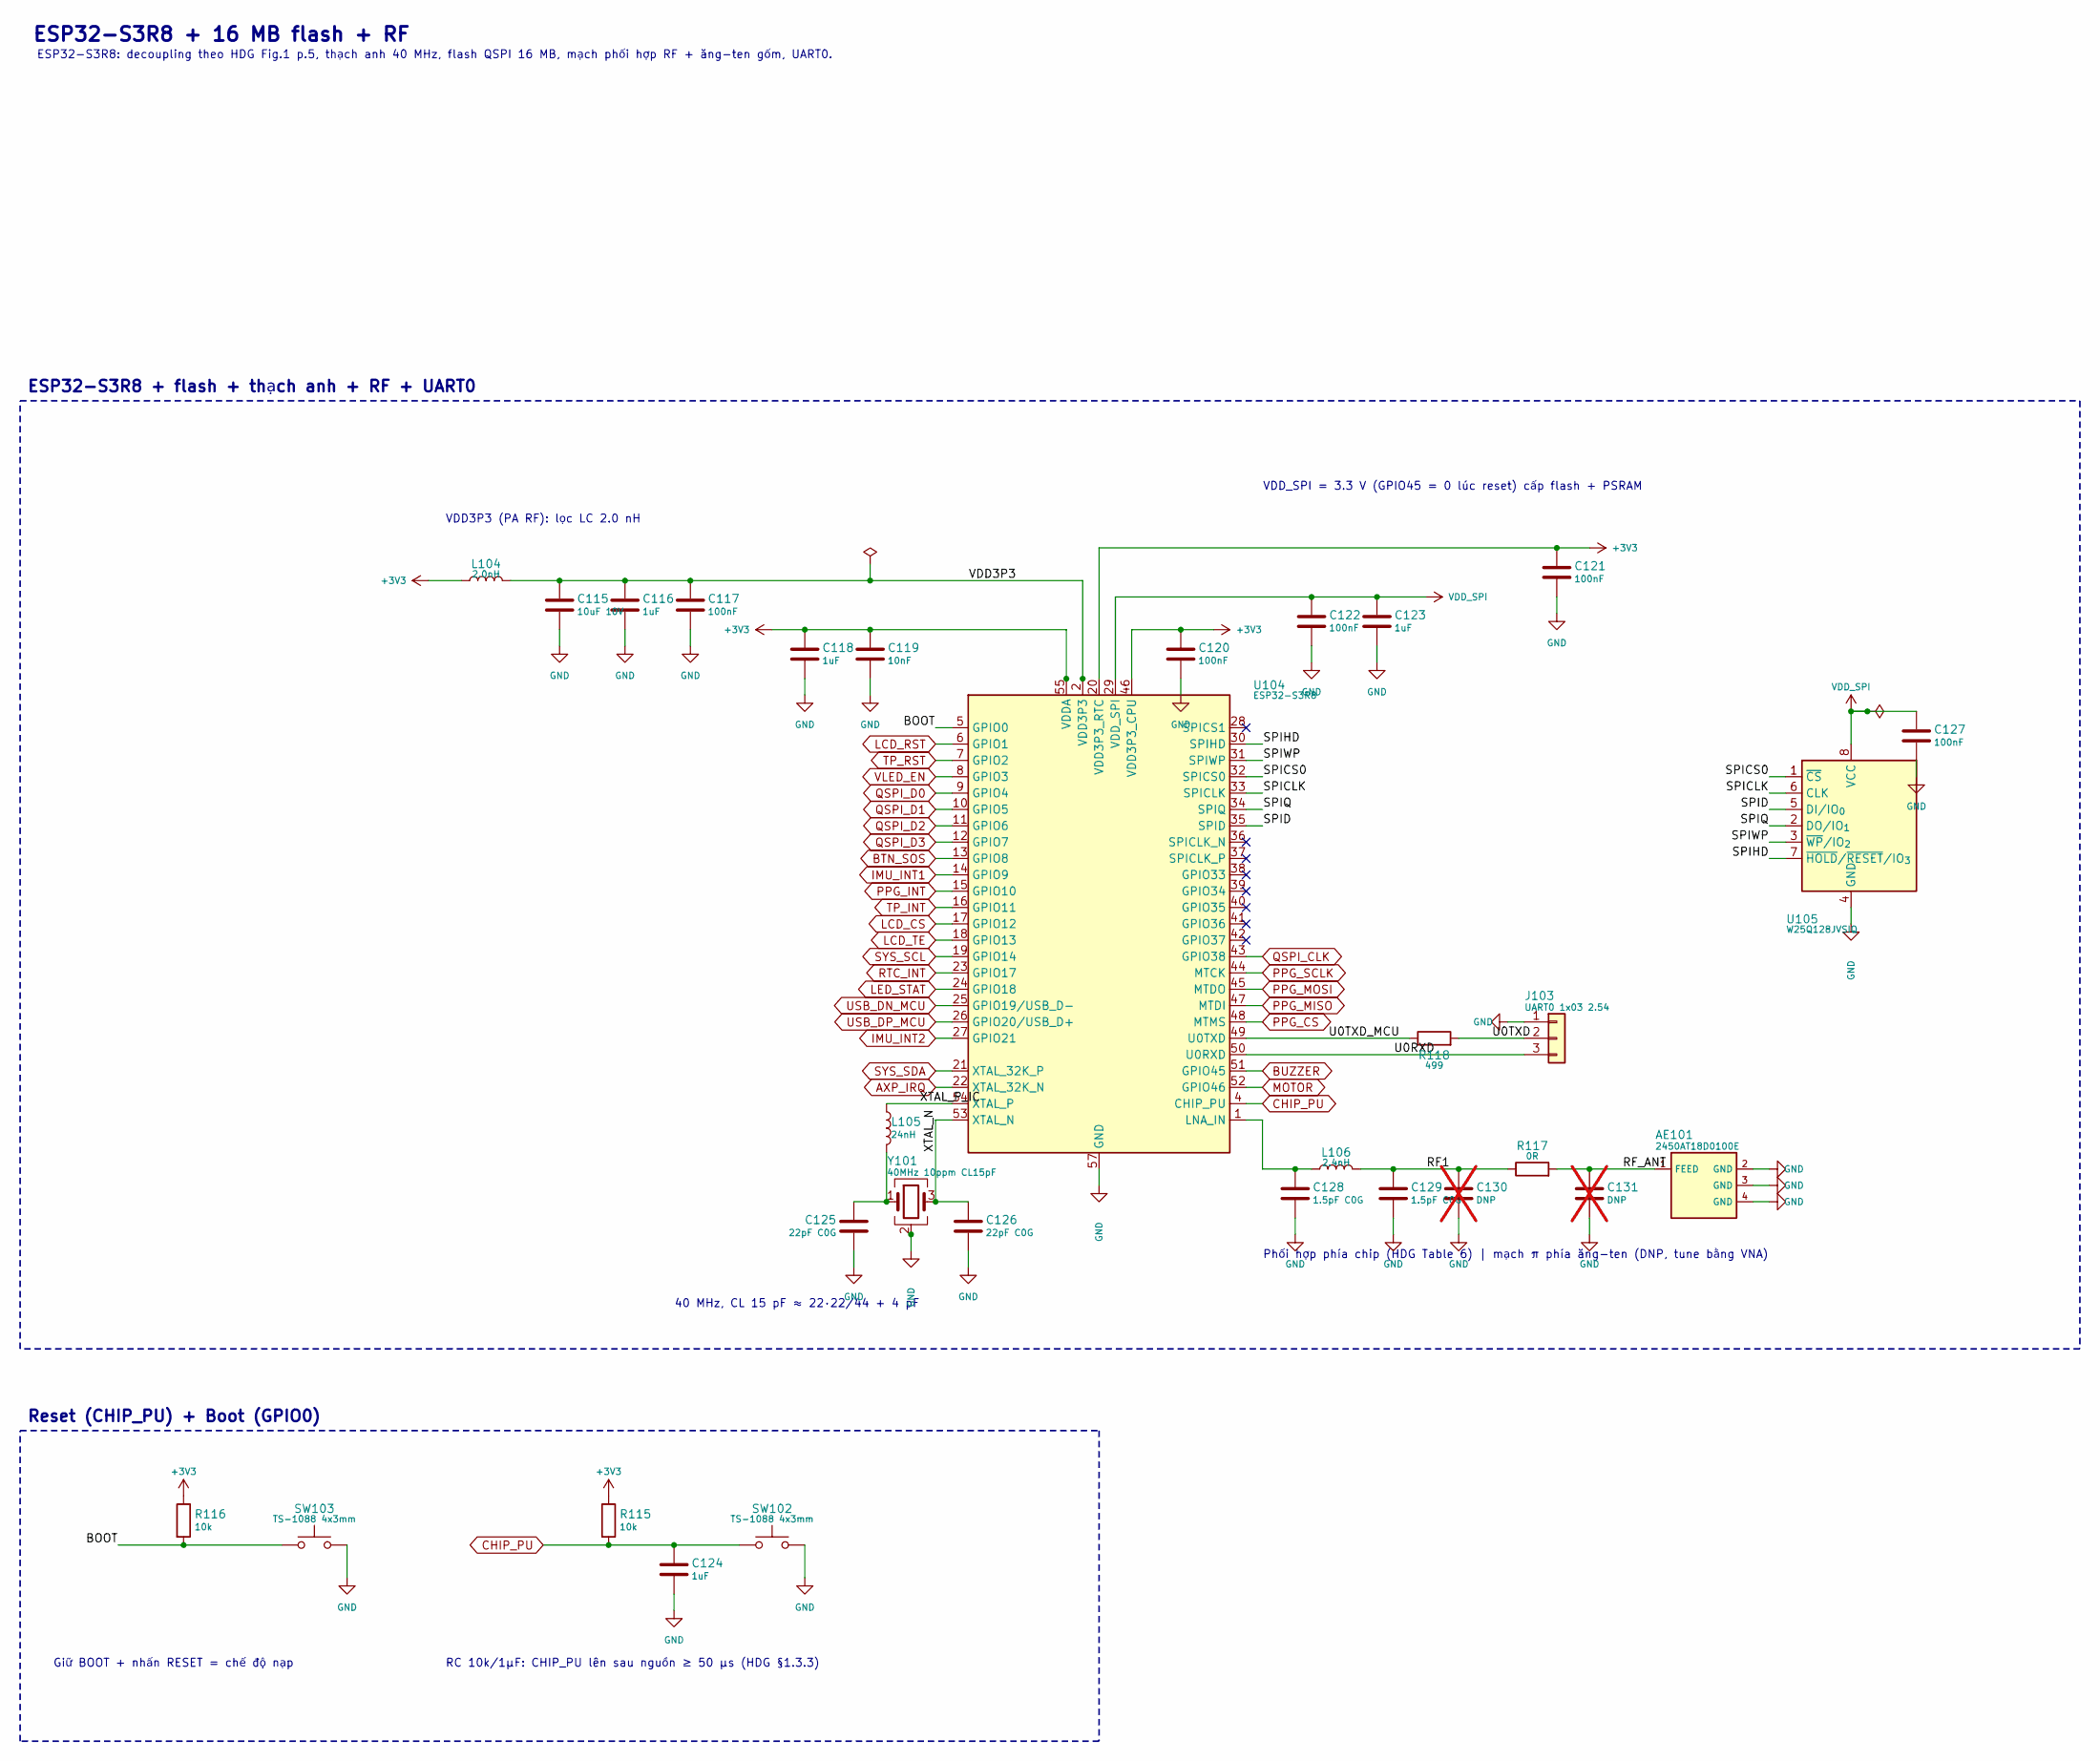
[picture p25: schematic health_watch_main_mcu.kicad_sch]

Parts:
AE101: 2450AT18D0100E; Johanson_2450AT18D_3.2x1.6mm; LCSC C2917718
C115: 10uF 10V; C_0603_1608Metric; LCSC C19702
C116, C118, C123, C124: 1uF; C_0402_1005Metric; LCSC C52923
C117, C120, C121, C122, C127: 100nF; C_0402_1005Metric; LCSC C1525
C119: 10nF; C_0402_1005Metric; LCSC C15195
C125, C126: 22pF C0G; C_0402_1005Metric; LCSC C1555
C128, C129: 1.5pF C0G; C_0201_0603Metric; LCSC C88905
C130, C131: DNP; C_0201_0603Metric; not fitted
J103: UART0 1x03 2.54; PinHeader_1x03_P2.54mm_Vertical; LCSC C2937625
L104: 2.0nH; L_0402_1005Metric; LCSC C76769
L105: 24nH; L_0402_1005Metric; LCSC C404641
L106: 2.4nH; L_0201_0603Metric; LCSC C98042
R115, R116: 10k; R_0402_1005Metric; LCSC C25744
R117: 0R; R_0201_0603Metric; LCSC C106228
R118: 499; R_0402_1005Metric; LCSC C4125
SW102, SW103: TS-1088 4x3mm; SW_SPST_TS-1088-xR020; LCSC C720477
U104: ESP32-S3R8; QFN-56-1EP_7x7mm_P0.4mm_EP4x4mm_ThermalVias; LCSC C2913194
U105: W25Q128JVSIQ; SOIC-8_5.3x5.3mm_P1.27mm; LCSC C97521
Y101: 40MHz 10ppm CL15pF; Crystal_SMD_3225-4Pin_3.2x2.5mm; LCSC C9010

Connections:
+3V3: C118.1, C119.1, C120.1, C121.1, L104.1, R115.1, R116.1, U104.20 (VDD3P3_RTC), U104.46 (VDD3P3_CPU), U104.55 (VDDA), U104.56 (VDDA)
AXP_IRQ: U104.22 (XTAL_32K_N)
BOOT: R116.2, SW103.1, U104.5 (GPIO0)
BTN_SOS: U104.13 (GPIO8)
BUZZER: U104.51 (GPIO45)
CHIP_PU: C124.1, R115.2, SW102.1, U104.4 (CHIP_PU)
GND: AE101.2 (GND), AE101.3 (GND), AE101.4 (GND), C115.2, C116.2, C117.2, C118.2, C119.2, C120.2, C121.2, C122.2, C123.2, C124.2, C125.2, C126.2, C127.2, C128.2, C129.2, C130.2, C131.2, J103.1, SW102.2, SW103.2, U104.57 (GND), U105.4 (GND), Y101.2 (G), Y101.4 (G)
IMU_INT1: U104.14 (GPIO9)
IMU_INT2: U104.27 (GPIO21)
LCD_CS: U104.17 (GPIO12)
LCD_RST: U104.6 (GPIO1)
LCD_TE: U104.18 (GPIO13)
LED_STAT: U104.24 (GPIO18)
MOTOR: U104.52 (GPIO46)
unnamed: C125.1, L105.2, Y101.1
unnamed: C128.1, L106.1, U104.1 (LNA_IN)
PPG_CS: U104.48 (MTMS)
PPG_INT: U104.15 (GPIO10)
PPG_MISO: U104.47 (MTDI)
PPG_MOSI: U104.45 (MTDO)
PPG_SCLK: U104.44 (MTCK)
QSPI_CLK: U104.43 (GPIO38)
QSPI_D0: U104.9 (GPIO4)
QSPI_D1: U104.10 (GPIO5)
QSPI_D2: U104.11 (GPIO6)
QSPI_D3: U104.12 (GPIO7)
RF1: C129.1, C130.1, L106.2, R117.1
RF_ANT: AE101.1 (FEED), C131.1, R117.2
RTC_INT: U104.23 (GPIO17)
SPICLK: U104.33 (SPICLK), U105.6 (CLK)
SPICS0: U104.32 (SPICS0), U105.1 (~CS)
SPID: U104.35 (SPID), U105.5 (DI/IO_{0})
SPIHD: U104.30 (SPIHD), U105.7 (~HOLD/~RESET/IO_{3})
SPIQ: U104.34 (SPIQ), U105.2 (DO/IO_{1})
SPIWP: U104.31 (SPIWP), U105.3 (~WP/IO_{2})
SYS_SCL: U104.19 (GPIO14)
SYS_SDA: U104.21 (XTAL_32K_P)
TP_INT: U104.16 (GPIO11)
TP_RST: U104.7 (GPIO2)
U0RXD: J103.3, U104.50 (U0RXD)
U0TXD: J103.2, R118.2
U0TXD_MCU: R118.1, U104.49 (U0TXD)
USB_DN_MCU: U104.25 (GPIO19/USB_D-)
USB_DP_MCU: U104.26 (GPIO20/USB_D+)
VDD3P3: C115.1, C116.1, C117.1, L104.2, U104.2 (VDD3P3), U104.3 (VDD3P3)
VDD_SPI: C122.1, C123.1, C127.1, U104.29 (VDD_SPI), U105.8 (VCC)
VLED_EN: U104.8 (GPIO3)
XTAL_N: C126.1, U104.53 (XTAL_N), Y101.3
XTAL_P_IC: L105.1, U104.54 (XTAL_P)

Notes on the sheet:
ESP32-S3R8 + 16 MB flash + RF
ESP32-S3R8: decoupling theo HDG Fig.1 p.5, thạch anh 40 MHz, flash QSPI 16 MB, mạch phối hợp RF + ăng-ten gốm, UART0.
ESP32-S3R8 + flash + thạch anh + RF + UART0
VDD3P3 (PA RF): lọc LC 2.0 nH
VDD_SPI = 3.3 V (GPIO45 = 0 lúc reset) cấp flash + PSRAM
40 MHz, CL 15 pF ≈ 22·22/44 + 4 pF
Phối hợp phía chip (HDG Table 6) | mạch π phía ăng-ten (DNP, tune bằng VNA)
Reset (CHIP_PU) + Boot (GPIO0)
RC 10k/1µF: CHIP_PU lên sau nguồn ≥ 50 µs (HDG §1.3.3)
Giữ BOOT + nhấn RESET = chế độ nạp
