harisama1/health-watch/hardware/main/health_watch_main_periph.kicad_sch

## KiCad design hardware/main/health_watch_main_periph.kicad_sch (2026-11-05)

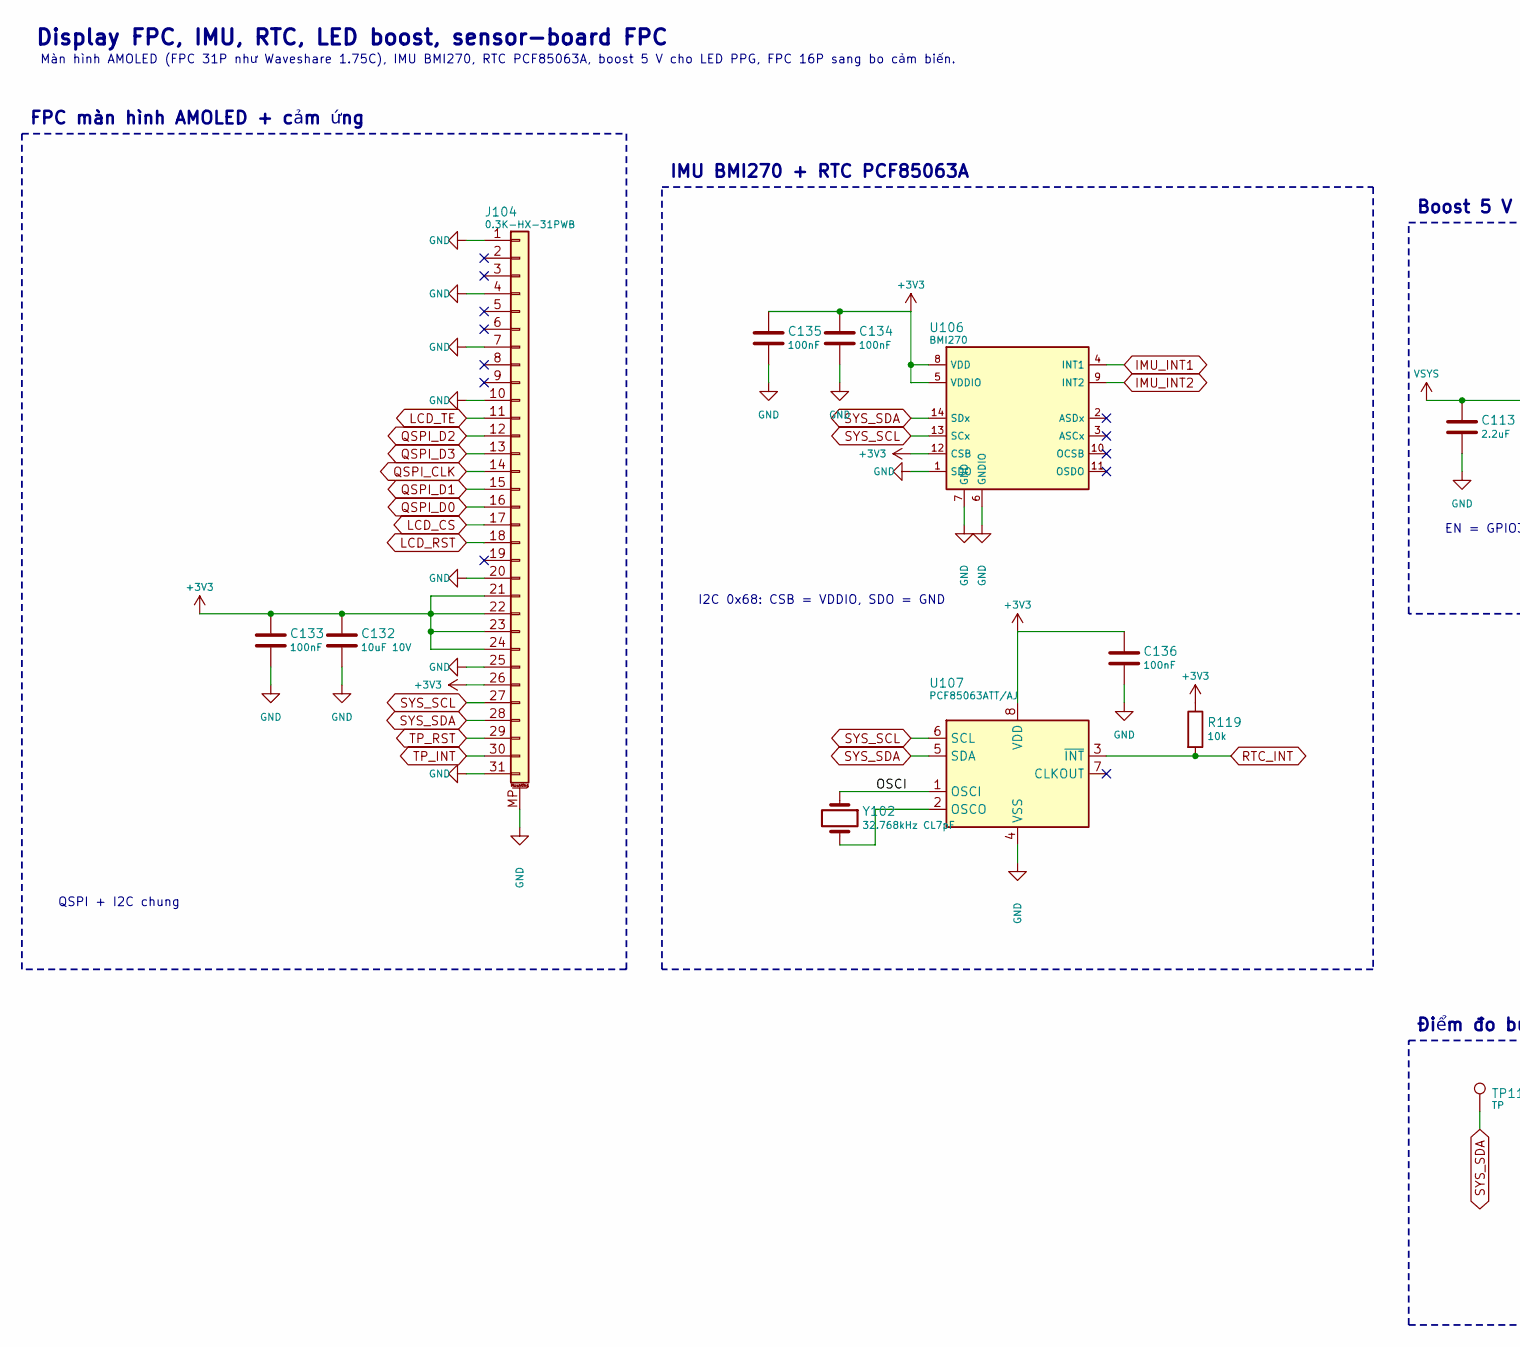
[picture p26: schematic health_watch_main_periph.kicad_sch, part in row 1, column 1]

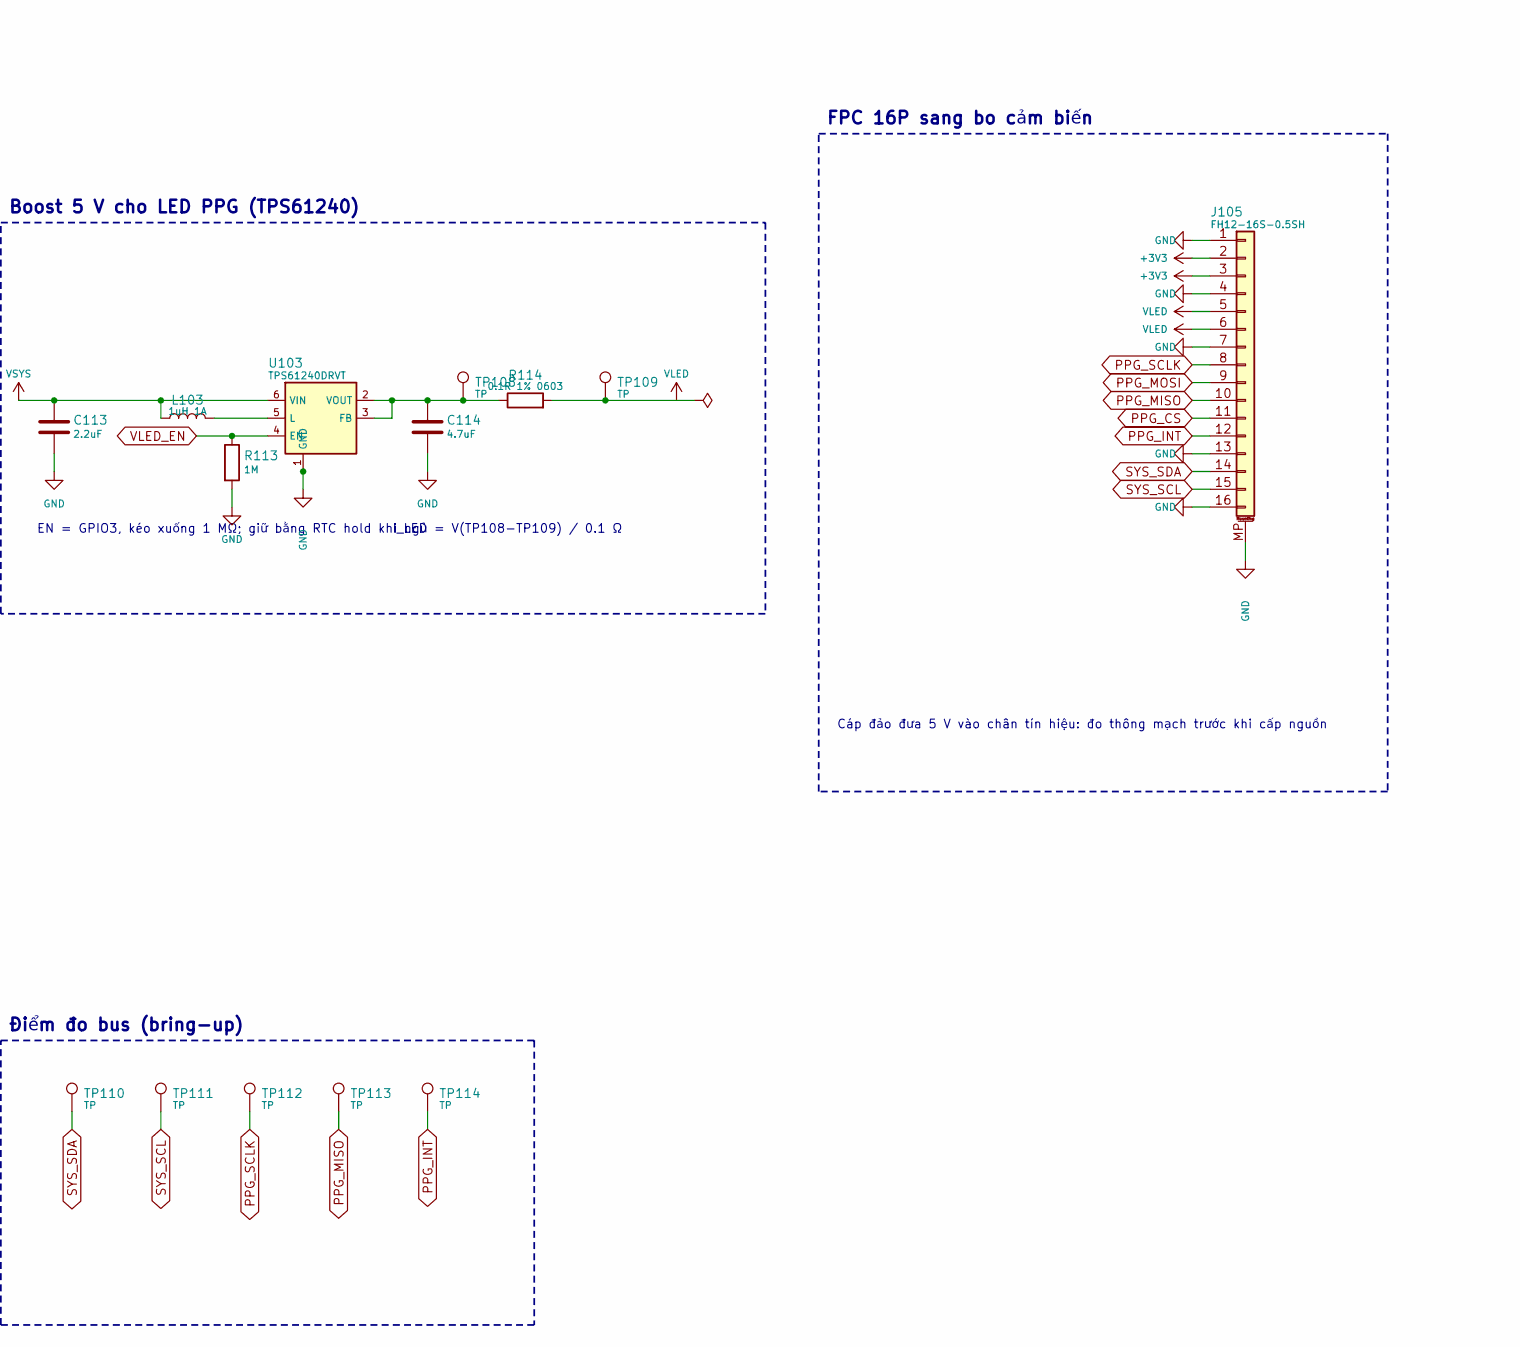
[picture p27: schematic health_watch_main_periph.kicad_sch, part in row 1, column 2]

Parts:
C113: 2.2uF; C_0402_1005Metric; LCSC C12530
C114: 4.7uF; C_0603_1608Metric; LCSC C19666
C132: 10uF 10V; C_0603_1608Metric; LCSC C19702
C133, C134, C135, C136: 100nF; C_0402_1005Metric; LCSC C1525
J104: 0.3K-HX-31PWB; FPC_HDGC_0.3K-HX-31PWB; LCSC C2919530
J105: FH12-16S-0.5SH; Hirose_FH12-16S-0.5SH_1x16-1MP_P0.50mm_Horizontal; LCSC C596731
L103: 1uH 1A; L_0805_2012Metric; LCSC C98332
R113: 1M; R_0402_1005Metric; LCSC C26083
R114: 0.1R 1% 0603; R_0603_1608Metric; LCSC C111027
R119: 10k; R_0402_1005Metric; LCSC C25744
TP108, TP109, TP110, TP111, TP112, TP113, TP114: TP; TestPoint_Pad_D1.0mm
U103: TPS61240DRVT; WSON-6-1EP_2x2mm_P0.65mm_EP1x1.6mm; LCSC C133991
U106: BMI270; Bosch_LGA-14_3x2.5mm_P0.5mm; LCSC C2836813
U107: PCF85063ATT/AJ; TSSOP-8_3x3mm_P0.65mm; LCSC C165608
Y102: 32.768kHz CL7pF; Crystal_SMD_2012-2Pin_2.0x1.2mm; LCSC C97602

Connections:
+3V3: C132.1, C133.1, C134.1, C135.1, C136.1, J104.21, J104.22, J104.23, J104.24, J104.26, J105.2, J105.3, R119.1, U106.5 (VDDIO), U106.8 (VDD), U106.12 (CSB), U107.8 (VDD)
GND: C113.2, C114.2, C132.2, C133.2, C134.2, C135.2, C136.2, J104.1, J104.4, J104.7, J104.10, J104.20, J104.25, J104.31, J104.MP (MountPin), J105.1, J105.4, J105.7, J105.13, J105.16, J105.MP (MountPin), R113.2, U103.1 (GND), U103.7 (GND), U106.1 (SDO), U106.6 (GNDIO), U106.7 (GND), U107.4 (VSS)
IMU_INT1: U106.4 (INT1)
IMU_INT2: U106.9 (INT2)
LCD_CS: J104.17
LCD_RST: J104.18
LCD_TE: J104.11
unnamed: C114.1, R114.1, TP108.1, U103.2 (VOUT), U103.3 (FB)
unnamed: L103.2, U103.5 (L)
unnamed: U107.2 (OSCO), Y102.2
OSCI: U107.1 (OSCI), Y102.1
PPG_CS: J105.11
PPG_INT: J105.12, TP114.1
PPG_MISO: J105.10, TP113.1
PPG_MOSI: J105.9
PPG_SCLK: J105.8, TP112.1
QSPI_CLK: J104.14
QSPI_D0: J104.16
QSPI_D1: J104.15
QSPI_D2: J104.12
QSPI_D3: J104.13
RTC_INT: R119.2, U107.3 (~INT)
SYS_SCL: J104.27, J105.15, TP111.1, U106.13 (SCx), U107.6 (SCL)
SYS_SDA: J104.28, J105.14, TP110.1, U106.14 (SDx), U107.5 (SDA)
TP_INT: J104.30
TP_RST: J104.29
VLED: J105.5, J105.6, R114.2, TP109.1
VLED_EN: R113.1, U103.4 (EN)
VSYS: C113.1, L103.1, U103.6 (VIN)

Notes on the sheet:
Display FPC, IMU, RTC, LED boost, sensor-board FPC
Màn hình AMOLED (FPC 31P như Waveshare 1.75C), IMU BMI270, RTC PCF85063A, boost 5 V cho LED PPG, FPC 16P sang bo cảm biến.
FPC màn hình AMOLED + cảm ứng
QSPI + I2C chung
Điểm đo bus (bring-up)
IMU BMI270 + RTC PCF85063A
I2C 0x68: CSB = VDDIO, SDO = GND
Boost 5 V cho LED PPG (TPS61240)
EN = GPIO3, kéo xuống 1 MΩ; giữ bằng RTC hold khi ngủ
I_LED = V(TP108-TP109) / 0.1 Ω
FPC 16P sang bo cảm biến
Cáp đảo đưa 5 V vào chân tín hiệu: đo thông mạch trước khi cấp nguồn
