harisama1/health-watch/hardware/main/health_watch_main_power.kicad_sch

## KiCad design hardware/main/health_watch_main_power.kicad_sch (2026-11-05)

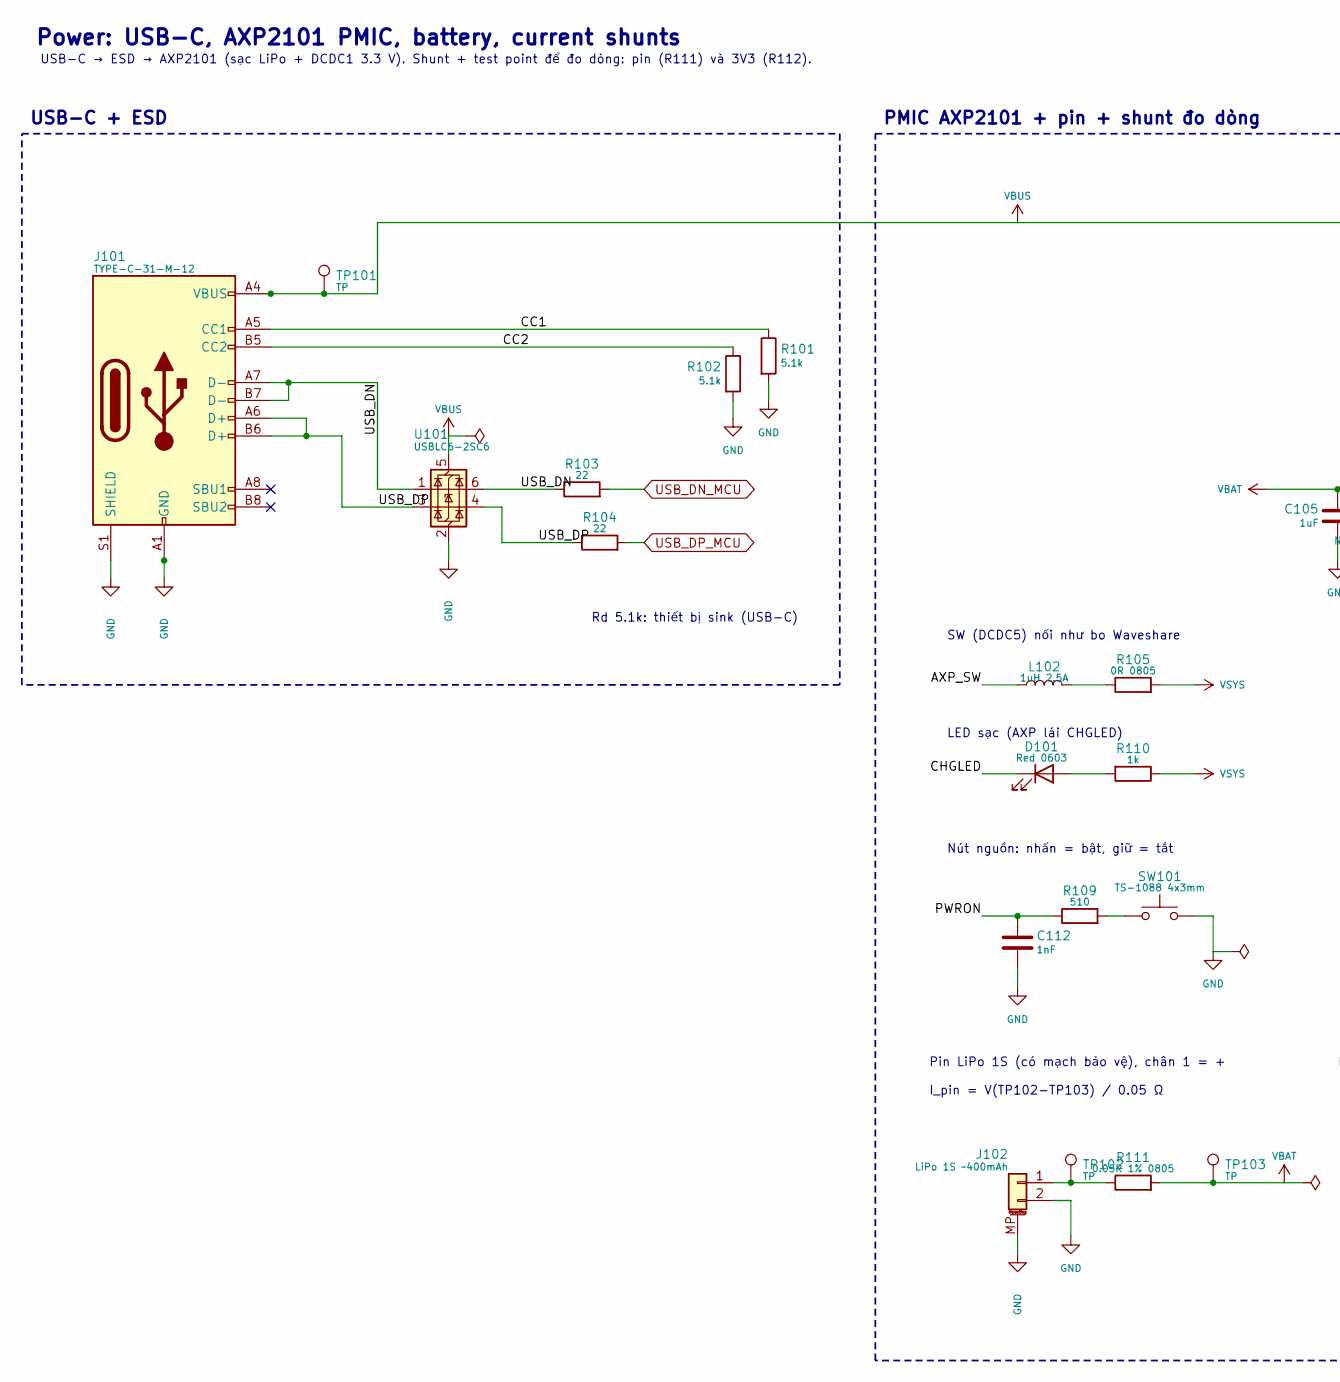
[picture p28: schematic health_watch_main_power.kicad_sch, part in row 1, column 1]

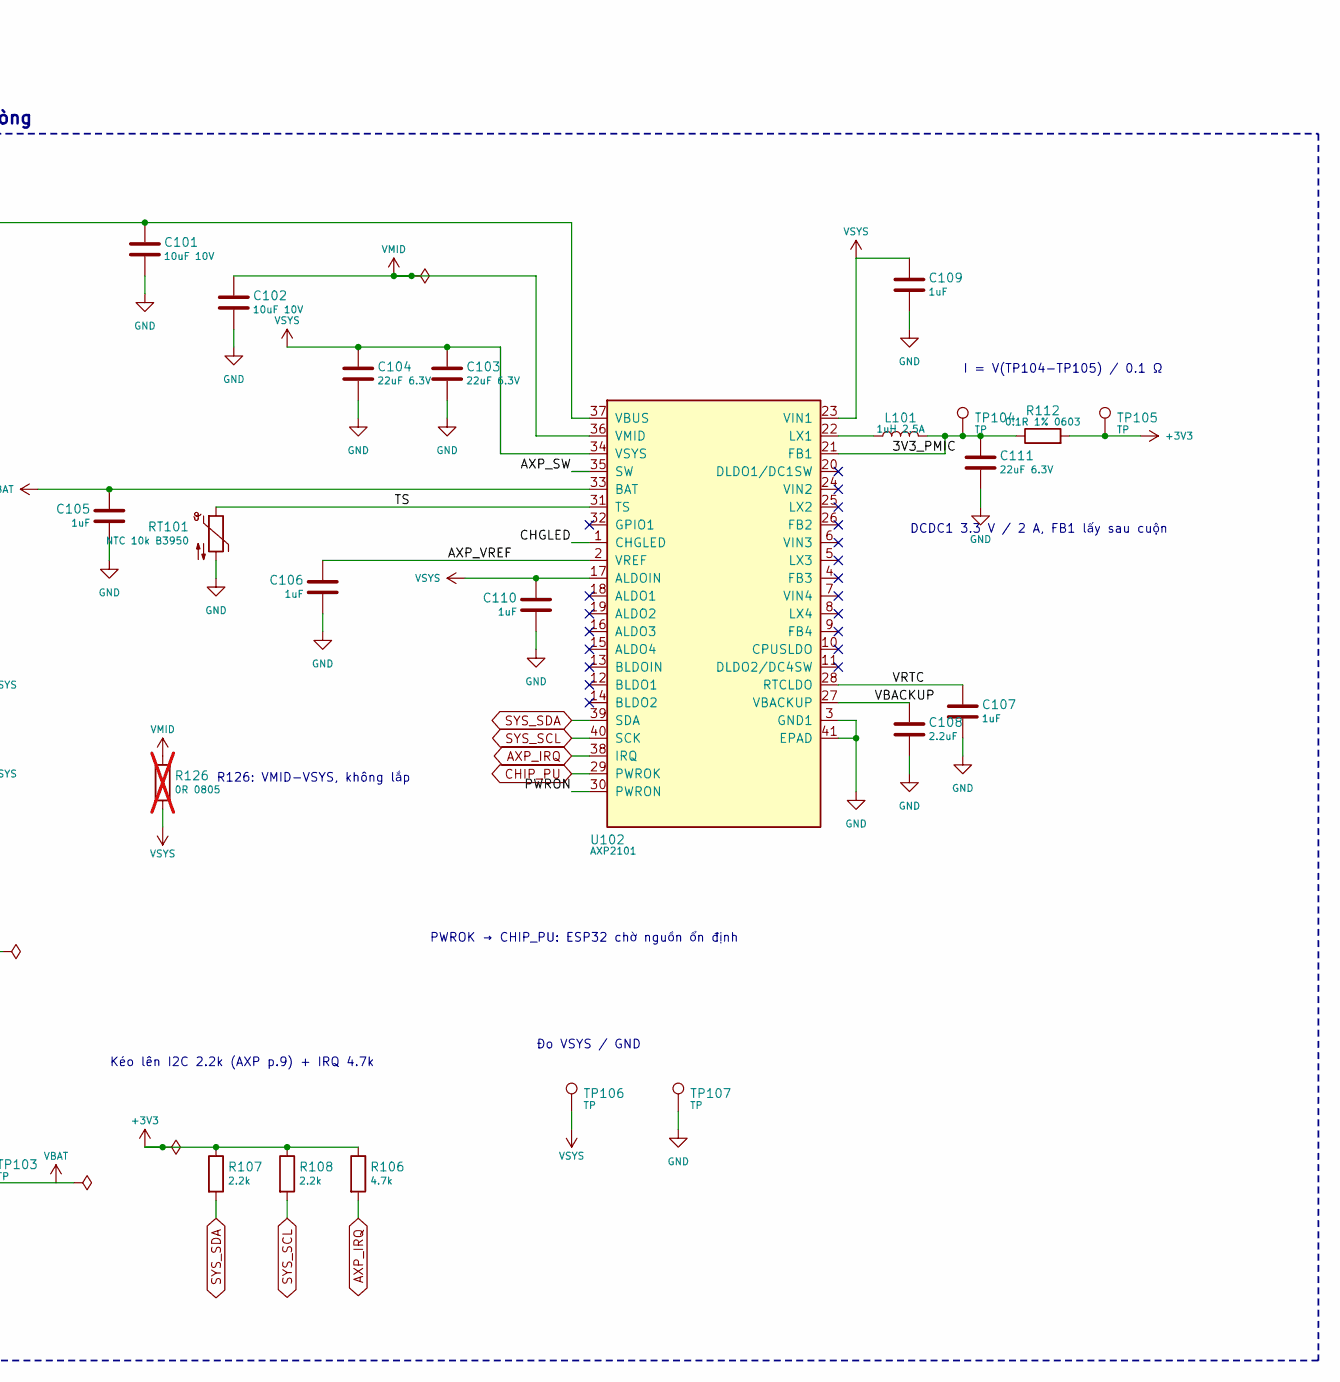
[picture p29: schematic health_watch_main_power.kicad_sch, part in row 1, column 2]

Parts:
C101, C102: 10uF 10V; C_0603_1608Metric; LCSC C19702
C103, C104, C111: 22uF 6.3V; C_0603_1608Metric; LCSC C59461
C105, C106, C107, C109, C110: 1uF; C_0402_1005Metric; LCSC C52923
C108: 2.2uF; C_0402_1005Metric; LCSC C12530
C112: 1nF; C_0402_1005Metric; LCSC C1523
D101: Red 0603; LED_0603_1608Metric; LCSC C2286
J101: TYPE-C-31-M-12; USB_C_Receptacle_16P_MidMount_TYPE-C-31-M-12; LCSC C165948
J102: LiPo 1S ~400mAh; Molex_PicoBlade_53261-0271_1x02-1MP_P1.25mm_Horizontal; LCSC C177225
L101, L102: 1uH 2.5A; L_1008_2520Metric; LCSC C97029
R101, R102: 5.1k; R_0402_1005Metric; LCSC C25905
R103, R104: 22; R_0402_1005Metric; LCSC C25092
R105: 0R 0805; R_0805_2012Metric; LCSC C17477
R106: 4.7k; R_0402_1005Metric; LCSC C25900
R107, R108: 2.2k; R_0402_1005Metric; LCSC C25879
R109: 510; R_0402_1005Metric; LCSC C25123
R110: 1k; R_0402_1005Metric; LCSC C11702
R111: 0.05R 1% 0805; R_0805_2012Metric; LCSC C247602
R112: 0.1R 1% 0603; R_0603_1608Metric; LCSC C111027
R126: 0R 0805; R_0805_2012Metric; LCSC C17477; not fitted
RT101: NTC 10k B3950; R_0402_1005Metric; LCSC C41366926
SW101: TS-1088 4x3mm; SW_SPST_TS-1088-xR020; LCSC C720477
TP101, TP102, TP103, TP104, TP105, TP106, TP107: TP; TestPoint_Pad_D1.0mm
U101: USBLC6-2SC6; SOT-23-6; LCSC C7519
U102: AXP2101; QFN-40-1EP_5x5mm_P0.4mm_EP3.6x3.6mm_ThermalVias; LCSC C3036461

Connections:
3V3_PMIC: C111.1, L101.2, R112.1, TP104.1, U102.21 (FB1)
+3V3: R106.1, R107.1, R108.1, R112.2, TP105.1
AXP_IRQ: R106.2, U102.38 (IRQ)
AXP_SW: L102.1, U102.35 (SW)
AXP_VREF: C106.1, U102.2 (VREF)
CC1: J101.A5 (CC1), R101.1
CC2: J101.B5 (CC2), R102.1
CHGLED: D101.1 (K), U102.1 (CHGLED)
CHIP_PU: U102.29 (PWROK)
GND: C101.2, C102.2, C103.2, C104.2, C105.2, C106.2, C107.2, C108.2, C109.2, C110.2, C111.2, C112.2, J101.A1 (GND), J101.A12 (GND), J101.B1 (GND), J101.B12 (GND), J101.S1 (SHIELD), J102.2, J102.MP (MountPin), R101.2, R102.2, RT101.2, SW101.2, TP107.1, U101.2 (GND), U102.3 (GND1), U102.41 (EPAD)
unnamed: D101.2 (A), R110.2
unnamed: J102.1, R111.1, TP102.1
unnamed: L101.1, U102.22 (LX1)
unnamed: L102.2, R105.1
unnamed: R109.2, SW101.1
PWRON: C112.1, R109.1, U102.30 (PWRON)
SYS_SCL: R108.2, U102.40 (SCK)
SYS_SDA: R107.2, U102.39 (SDA)
TS: RT101.1, U102.31 (TS)
USB_DN: J101.A7 (D-), J101.B7 (D-), R103.1, U101.1 (I/O1), U101.6 (I/O1)
USB_DN_MCU: R103.2
USB_DP: J101.A6 (D+), J101.B6 (D+), R104.1, U101.3 (I/O2), U101.4 (I/O2)
USB_DP_MCU: R104.2
VBACKUP: C108.1, U102.27 (VBACKUP)
VBAT: C105.1, R111.2, TP103.1, U102.33 (BAT)
VBUS: C101.1, J101.A4 (VBUS), J101.A9 (VBUS), J101.B4 (VBUS), J101.B9 (VBUS), TP101.1, U101.5 (VBUS), U102.37 (VBUS)
VMID: C102.1, R126.1, U102.36 (VMID)
VRTC: C107.1, U102.28 (RTCLDO)
VSYS: C103.1, C104.1, C109.1, C110.1, R105.2, R110.1, R126.2, TP106.1, U102.17 (ALDOIN), U102.23 (VIN1), U102.34 (VSYS)

Notes on the sheet:
Power: USB-C, AXP2101 PMIC, battery, current shunts
USB-C → ESD → AXP2101 (sạc LiPo + DCDC1 3.3 V). Shunt + test point để đo dòng: pin (R111) và 3V3 (R112).
USB-C + ESD
Rd 5.1k: thiết bị sink (USB-C)
PMIC AXP2101 + pin + shunt đo dòng
DCDC1 3.3 V / 2 A, FB1 lấy sau cuộn
R126: VMID-VSYS, không lắp
SW (DCDC5) nối như bo Waveshare
LED sạc (AXP lái CHGLED)
Nút nguồn: nhấn = bật, giữ = tắt
I = V(TP104-TP105) / 0.1 Ω
Pin LiPo 1S (có mạch bảo vệ), chân 1 = +
I_pin = V(TP102-TP103) / 0.05 Ω
Đo VSYS / GND
Kéo lên I2C 2.2k (AXP p.9) + IRQ 4.7k
PWROK → CHIP_PU: ESP32 chờ nguồn ổn định
