harisama1/health-watch/hardware/main/health_watch_main_ui.kicad_sch

## KiCad design hardware/main/health_watch_main_ui.kicad_sch (2026-11-05)

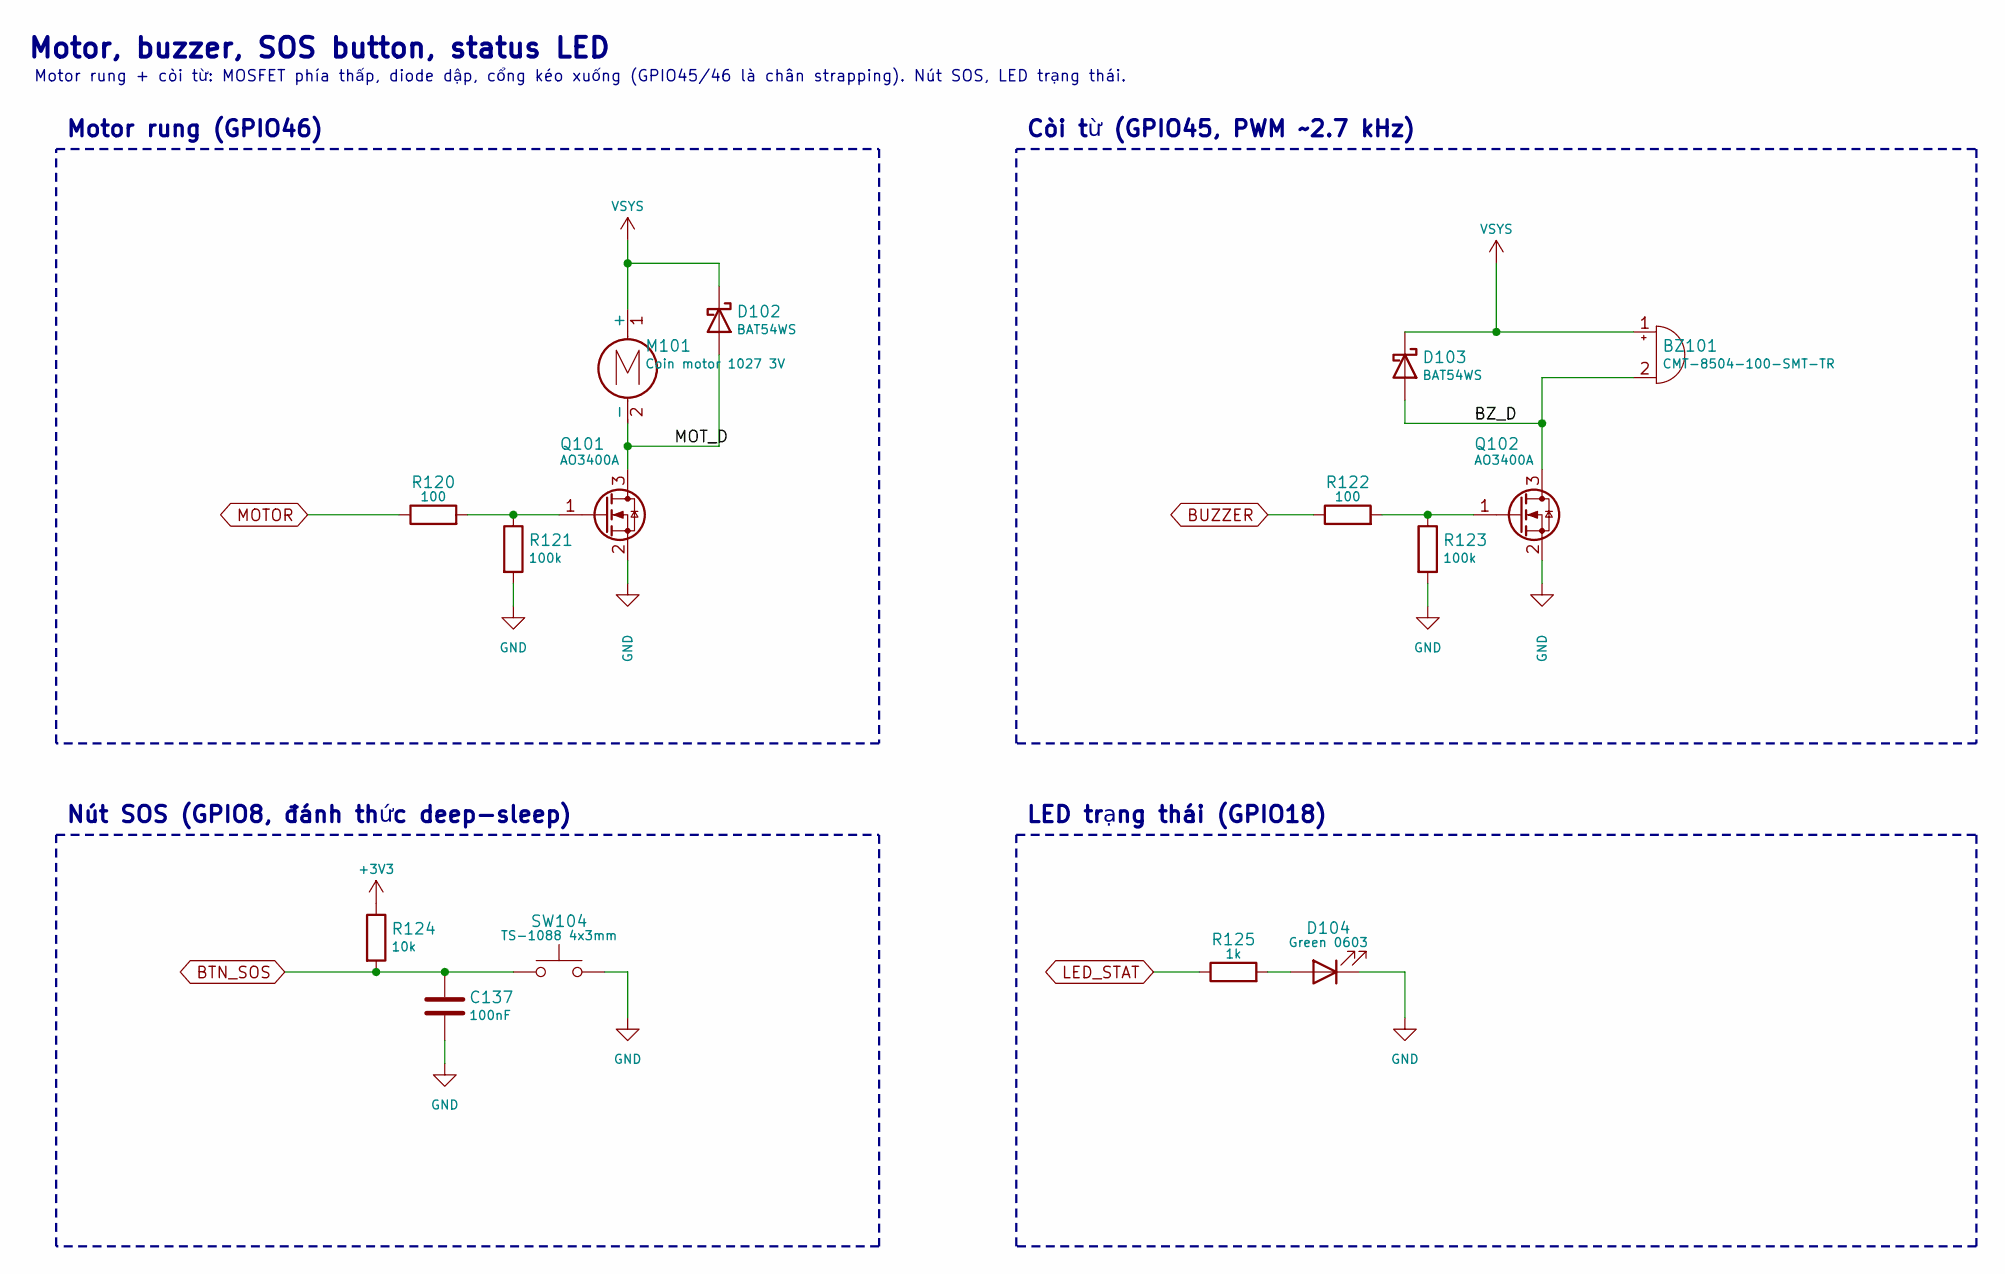
[picture p30: schematic health_watch_main_ui.kicad_sch]

Parts:
BZ101: CMT-8504-100-SMT-TR; MagneticBuzzer_CUI_CMT-8504-100-SMT; LCSC C22359707
C137: 100nF; C_0402_1005Metric; LCSC C1525
D102, D103: BAT54WS; D_SOD-323; LCSC C22629
D104: Green 0603; LED_0603_1608Metric; LCSC C12624
M101: Coin motor 1027 3V; Motor_Pads_2x1.5mm; LCSC C2759984
Q101, Q102: AO3400A; SOT-23; LCSC C20917
R120, R122: 100; R_0402_1005Metric; LCSC C25076
R121, R123: 100k; R_0402_1005Metric; LCSC C25741
R124: 10k; R_0402_1005Metric; LCSC C25744
R125: 1k; R_0402_1005Metric; LCSC C11702
SW104: TS-1088 4x3mm; SW_SPST_TS-1088-xR020; LCSC C720477

Connections:
+3V3: R124.1
BTN_SOS: C137.1, R124.2, SW104.1
BUZZER: R122.1
BZ_D: BZ101.2 (-), D103.2 (A), Q102.3 (D)
GND: C137.2, D104.1 (K), Q101.2 (S), Q102.2 (S), R121.2, R123.2, SW104.2
LED_STAT: R125.1
MOTOR: R120.1
MOT_D: D102.2 (A), M101.2 (-), Q101.3 (D)
unnamed: D104.2 (A), R125.2
unnamed: Q101.1 (G), R120.2, R121.1
unnamed: Q102.1 (G), R122.2, R123.1
VSYS: BZ101.1 (+), D102.1 (K), D103.1 (K), M101.1 (+)

Notes on the sheet:
Motor, buzzer, SOS button, status LED
Motor rung + còi từ: MOSFET phía thấp, diode dập, cổng kéo xuống (GPIO45/46 là chân strapping). Nút SOS, LED trạng thái.
Motor rung (GPIO46)
Còi từ (GPIO45, PWM ~2.7 kHz)
Nút SOS (GPIO8, đánh thức deep-sleep)
LED trạng thái (GPIO18)
