harisama1/health-watch/hardware/sensor/health_watch_sensor_sensor.kicad_sch

## KiCad design hardware/sensor/health_watch_sensor_sensor.kicad_sch (2026-11-05)

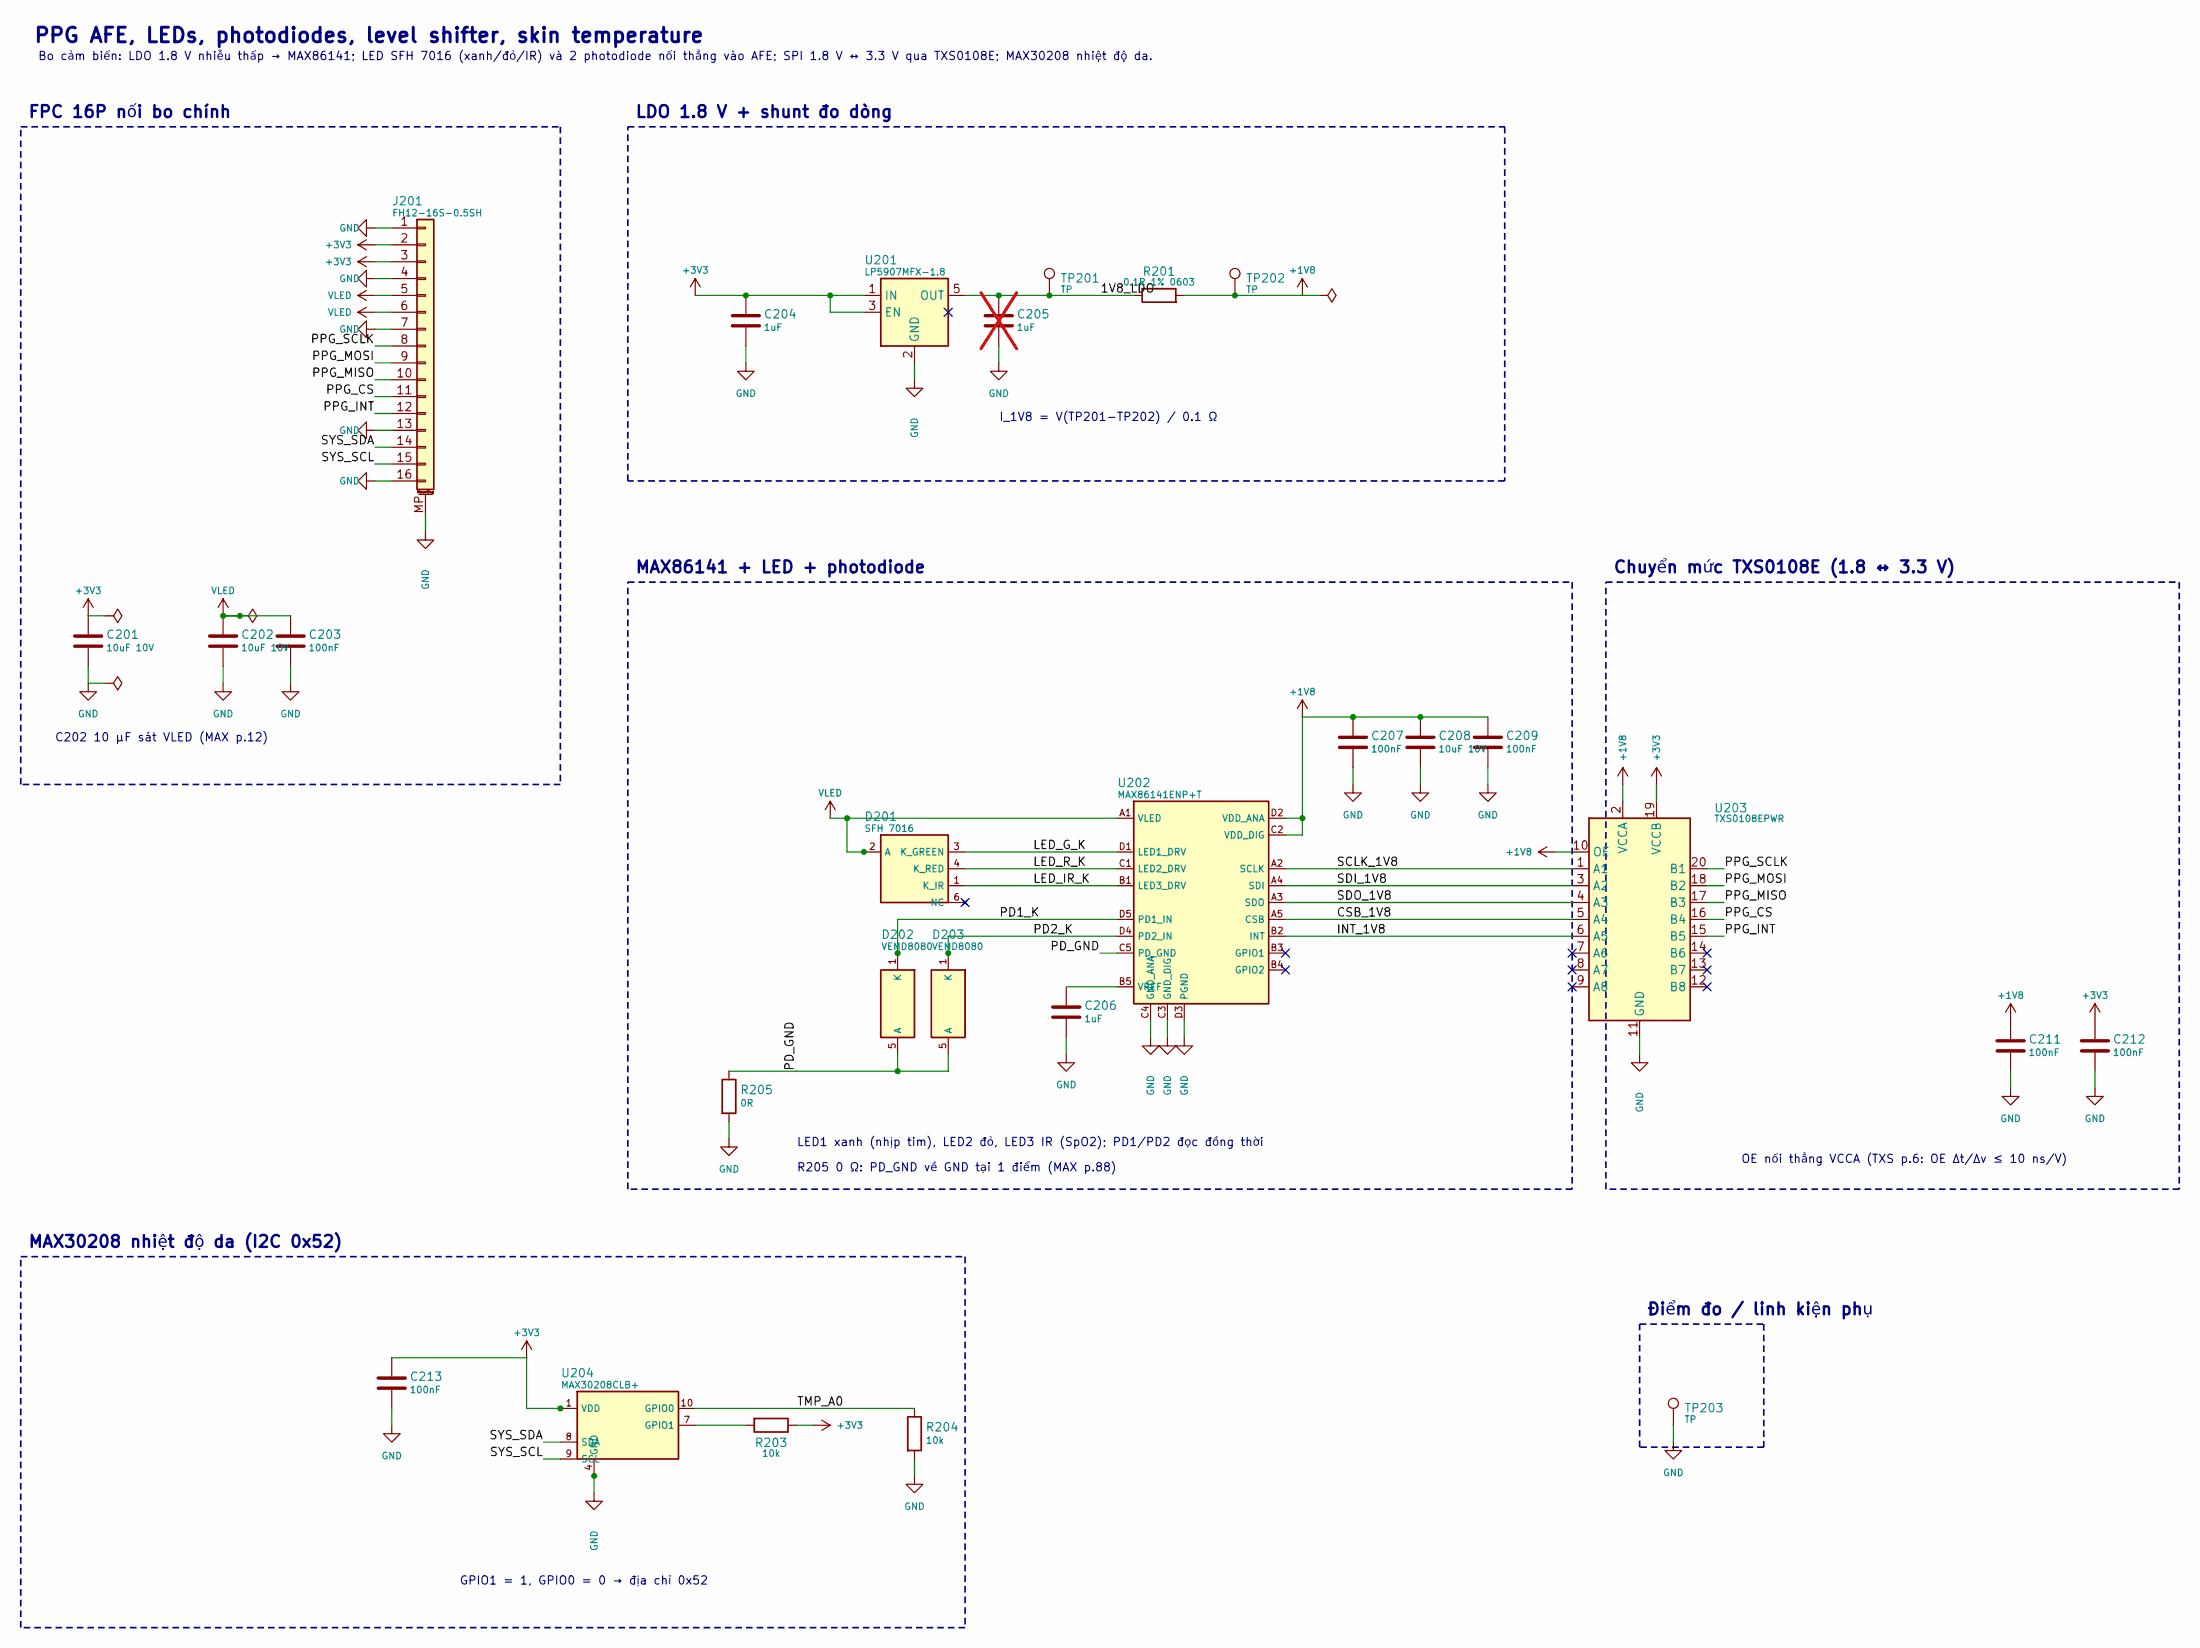
[picture p31: schematic health_watch_sensor_sensor.kicad_sch]

Parts:
C201, C202, C208: 10uF 10V; C_0603_1608Metric; LCSC C19702
C203, C207, C209, C211, C212, C213: 100nF; C_0402_1005Metric; LCSC C1525
C204, C206: 1uF; C_0402_1005Metric; LCSC C52923
C205: 1uF; C_0402_1005Metric; LCSC C52923; not fitted
D201: SFH 7016; SFH7016_1.85x1.65mm; MPN Q65112A7849 (mã ams-OSRAM; chưa có mã L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
D202, D203: VEMD8080; VEMD8080_4.8x2.5mm; LCSC C511402
J201: FH12-16S-0.5SH; Hirose_FH12-16S-0.5SH_1x16-1MP_P0.50mm_Horizontal; LCSC C596731
R201: 0.1R 1% 0603; R_0603_1608Metric; LCSC C111027
R203, R204: 10k; R_0402_1005Metric; LCSC C25744
R205: 0R; R_0402_1005Metric; LCSC C17168
TP201, TP202, TP203: TP; TestPoint_Pad_D1.0mm
U201: LP5907MFX-1.8; SOT-23-5; LCSC C92498
U202: MAX86141ENP+T; MAX86141_WLP-20_2.05x1.85mm_P0.4mm; LCSC C5328762
U203: TXS0108EPWR; TSSOP-20_4.4x6.5mm_P0.65mm; LCSC C17206
U204: MAX30208CLB+; MAX30208_LGA-10_2x2mm_PRELIM; LCSC C2874216

Connections:
1V8_LDO: C205.1, R201.1, TP201.1, U201.5 (OUT)
+1V8: C207.1, C208.1, C209.1, C211.1, R201.2, TP202.1, U202.C2 (VDD_DIG), U202.D2 (VDD_ANA), U203.2 (VCCA), U203.10 (OE)
+3V3: C201.1, C204.1, C212.1, C213.1, J201.2, J201.3, R203.1, U201.1 (IN), U201.3 (EN), U203.19 (VCCB), U204.1 (VDD), U204.2 (VDD), U204.3 (VDD)
CSB_1V8: U202.A5 (CSB), U203.5 (A4)
GND: C201.2, C202.2, C203.2, C204.2, C205.2, C206.2, C207.2, C208.2, C209.2, C211.2, C212.2, C213.2, J201.1, J201.4, J201.7, J201.13, J201.16, J201.MP (MountPin), R204.2, R205.2, TP203.1, U201.2 (GND), U202.C3 (GND_DIG), U202.C4 (GND_ANA), U202.D3 (PGND), U203.11 (GND), U204.4 (GND), U204.5 (GND), U204.6 (GND)
INT_1V8: U202.B2 (INT), U203.6 (A5)
LED_G_K: D201.3 (K_GREEN), U202.D1 (LED1_DRV)
LED_IR_K: D201.1 (K_IR), U202.B1 (LED3_DRV)
LED_R_K: D201.4 (K_RED), U202.C1 (LED2_DRV)
unnamed: C206.1, U202.B5 (VREF)
unnamed: R203.2, U204.7 (GPIO1)
PD1_K: D202.1 (K), D202.2 (K), D202.3 (K), D202.4 (K), D202.6 (K), D202.7 (K), D202.8 (K), U202.D5 (PD1_IN)
PD2_K: D203.1 (K), D203.2 (K), D203.3 (K), D203.4 (K), D203.6 (K), D203.7 (K), D203.8 (K), U202.D4 (PD2_IN)
PD_GND: D202.5 (A), D203.5 (A), R205.1, U202.C5 (PD_GND)
PPG_CS: J201.11, U203.16 (B4)
PPG_INT: J201.12, U203.15 (B5)
PPG_MISO: J201.10, U203.17 (B3)
PPG_MOSI: J201.9, U203.18 (B2)
PPG_SCLK: J201.8, U203.20 (B1)
SCLK_1V8: U202.A2 (SCLK), U203.1 (A1)
SDI_1V8: U202.A4 (SDI), U203.3 (A2)
SDO_1V8: U202.A3 (SDO), U203.4 (A3)
SYS_SCL: J201.15, U204.9 (SCL)
SYS_SDA: J201.14, U204.8 (SDA)
TMP_A0: R204.1, U204.10 (GPIO0)
VLED: C202.1, C203.1, D201.2 (A), D201.5 (A), J201.5, J201.6, U202.A1 (VLED)

Notes on the sheet:
PPG AFE, LEDs, photodiodes, level shifter, skin temperature
Bo cảm biến: LDO 1.8 V nhiễu thấp → MAX86141; LED SFH 7016 (xanh/đỏ/IR) và 2 photodiode nối thẳng vào AFE; SPI 1.8 V ↔ 3.3 V qua TXS0108E; MAX30208 nhiệt độ da.
FPC 16P nối bo chính
C202 10 µF sát VLED (MAX p.12)
LDO 1.8 V + shunt đo dòng
I_1V8 = V(TP201-TP202) / 0.1 Ω
MAX86141 + LED + photodiode
LED1 xanh (nhịp tim), LED2 đỏ, LED3 IR (SpO2); PD1/PD2 đọc đồng thời
R205 0 Ω: PD_GND về GND tại 1 điểm (MAX p.88)
Chuyển mức TXS0108E (1.8 ↔ 3.3 V)
OE nối thẳng VCCA (TXS p.6: OE Δt/Δv ≤ 10 ns/V)
MAX30208 nhiệt độ da (I2C 0x52)
GPIO1 = 1, GPIO0 = 0 → địa chỉ 0x52
Điểm đo / linh kiện phụ
