harisama1/health-watch/(commit log)

2026-11-03 Health-monitoring smartwatch (đồ án): design, hand-wired schematics, diagrams, report, citations
    ESP32-S3R8 + AXP2101 + AMOLED 1.75" main board and a MAX86141/MAX30208 sensor board joined by
    a 16-pin FPC. Edge AI on the watch (fall/activity, irregular rhythm, sleep/stress), HTTPS to a web
    dashboard with BLE fallback.
    - tools/design.py: parts, nets, reasons, datasheet citations (single source of truth)
    - hardware/: KiCad 9 projects (ERC 0, netlist matches design.py) + project libraries
    - outputs/: design-analysis report, schematics, citation index (PDF), block/power/data-flow diagrams
    - deliverable/DoAn_DongHo_SucKhoe/: everything bundled for submission
    - vendor datasheets are linked, no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
    [health_watch_main.kicad_sch, health_watch_main_mcu.kicad_sch, health_watch_main_periph.kicad_sch, health_watch_main_power.kicad_sch, health_watch_main_ui.kicad_sch, health_watch_sensor.kicad_sch, health_watch_sensor_sensor.kicad_sch]
2026-11-05 Review and correct the design; rewrite reports as Word documents
    Schematic (Rev 1.2):
    - Separate PD_GND from GND through R205 (MAX86141 p.12, p.88)
    - Tie TXS0108E OE to VCCA and remove the slow RC (TXS p.6)
    - Mark C205 DNP: LP5907 output capacitance limit is 10 uF (LP p.7)
    - Replace discontinued SFH 7013 with SFH 7016: new symbol and footprint
    - Add R126 (VMID-VSYS, DNP); enlarge R105 to 0805, it carries USB current
    - R113 to 1M, RF matching parts to 0201, add bus test points TP110-114
    - Add HW_IC to the project library table
    BOM:
    - Remove LCSC codes that resolved to the wrong part
    - Add tools/check_bom.py: 39 codes match, 0 wrong, 23 items still need a code
    Plan:
    - New alert logic to limi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
    [health_watch_main.kicad_sch, health_watch_main_mcu.kicad_sch, health_watch_main_periph.kicad_sch, health_watch_main_power.kicad_sch, health_watch_main_ui.kicad_sch, health_watch_sensor.kicad_sch, health_watch_sensor_sensor.kicad_sch]
2026-11-05 Add JLCPCB BOM and swap out-of-stock parts
    Replace the parts that have no stock with equivalents that do not change
    the design's results: PCF85063ATT RTC, 2450AT18D antenna, KT-0603G status
    LED, and an HDGC 31-pin FPC connector with a footprint from its drawing.
    Fill the missing LCSC codes and check them against JLCPCB and LCSC.
    Keep MAX86141 and SFH 7016: the MAXM86161 module has one photodiode and is
    optimised for in-ear use, so it cannot be shown to leave results unchanged.
    Both parts and the 1.75" panel are still not orderable on JLCPCB/LCSC.
    Add tools/gen_bom.py for the BOM workbook, cost estimate and JLCPCB CSVs.
    Update reports to design Rev 2.2 and schematic Rev 1.3, and stop treati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
    [health_watch_bom.xlsx, health_watch_main.kicad_sch, health_watch_main_jlc_bom.csv, health_watch_main_mcu.kicad_sch, health_watch_main_periph.kicad_sch, health_watch_main_power.kicad_sch, health_watch_main_ui.kicad_sch, health_watch_sensor.kicad_sch]
2026-11-06 Add module-stage BOM with Shopee search links
    List the bought modules needed to run the firmware and software before any
    custom PCB: ESP32-S3 DevKitC, round LCD, BMI160, MAX30102, DS18B20, PCF8563,
    charger, boost, battery, motor, buzzer and wiring. Each row states how it
    differs from the PCB design and links to a Shopee keyword search.
    The substitutes apply to this stage only; the PCB design is unchanged.
    Shopee prices and stock were not checked, so their column is left to fill in.
    [health_watch_module_bom.xlsx]
